hyyj04/Bio-Grip/Mentoring/팀활동 사진/260414_BioGrip팀사진2.jpg

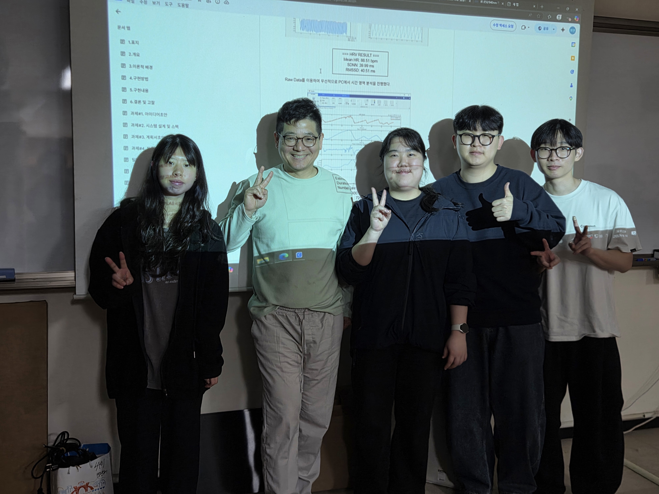
Mentoring/팀활동 사진/260414_BioGrip팀사진2.jpg
