hyyj04/Bio-Grip/Mentoring/멘토링.md

# 멘토링

4월 14일 회요일 
17:40 ~ 20:40

1. 동작에 필요한 AFE 모드 및 아두이노 보드 확보 및 단품동작확인
2. 마우스 분해하여 기구 관련 검토 진행중
    - 마우스 회로만 활용하구 기구는 3D 프린터로 출력필요
    - 공개된 디자인을 직접 출력하여 검토 후 모델선정
3.2개 트랙으로 진행
  - 아두이노에 AFE 연결하여 기본데이터 취득 및 PC로전송
  - PC에서는 받은데이터를 차트로 출력하고 필요한 필터를 설계하여 동작검토
4. 생체신호 측정은 AFE로 젲가 및 데이타 확보가 가능하지만 분석하여 원하는 피처를 찾는 과정이 시간이 많이 걸리고 난이도가 높ㅇ.ㅁ

기타
중간고사 끝나고 4월말 석식미팅

2026-05-28 17:30
415-1호 강의실
인원 : 조희재강사(삼성전자) / 임세훈(멘토) / 멘티
1. 진행
   - VScode 워크스페이스 설정 및 코파일럿 설정 / 코덱스 설정 .
   - 채팅창을 이용한 코드 실습 : ESP32 + 네오LED
   - 사양서를 이용한 코드 실습 : ESP32 + 네오 LED + Wifi
   -  AI에이전트 활용시 효율 올리는 방법 및 사양서의 중용성 / 기본템플릿 소개등
2. 근처 식당에서 늦은 식사를 같이 하면서 강사님 및 멘토와 회사 실무 및 AI 활용등 간담하면서 진행됨
3. 
AI활용한 프로젝트 구성 및 코드 개발 등의 실습 세미나로 2개 과제 같이 진행함.

2026-07-08 19:00  
1. 진행 상황 공유
 - 바이오 그립 과제는 6월에는 깃허브로 자료 공유및 이슈체크만 진행되고 오프라인 멘토링은 스킵
 - 하드웨어 제작 완료 및 PC연동으로 데이터 취득 및 평가/ 알고리즘으로 수치화까지 완료하여 졸작발표 완료
 - 졸작 진행 동영상 공유 및  동작 설명 진행

2. 중간 보고서 관련 이슈
 - 중간보고서는 일정준수가 필요하며 당일 서버 혼잡으로 다운등이 있으니 빠른 진행 당부
- 초안 작성되는데로 전달하면 리뷰하기로함

3. 과제 진행관련 이슈
 - 하드웨어 최적화를 적용하여 신규제작이슈
 - 마우스 구매 및 형상, 센서 배치등 의견 공유 및 토론

4. 프로젝트 중간까지 진행 응원하면서 식사로 멘토링 마무리
