hyyj04/Bio-Grip/Docs/docs/02_HW사양서.md

# BioGrip 하드웨어 사양서

## 1. 개요 (Introduction)

### 1.1. 문서 목적 및 범위 (Purpose & Scope)

본 사양서는 사용자의 인지적·물리적 부담을 최소화하는 마우스 일체형 무구속 생체신호 계측 시스템의 하드웨어 스펙을 정의한다. 기존 유선 마우스 하우징 내부의 한정된 공간에 메인 컨트롤러(Arduino Nano 33 BLE), 광학식 반사형 PPG 센서, 그리고 아날로그 GSR 전극 인터페이스 회로를 집적하기 위한 전기적, 기구적, 전원 관리 사양을 규정하여 시스템의 하드웨어 신뢰성을 보장하는 데 목적이 있다.

### 1.2. 시스템 하드웨어 블록도 (System Hardware Block Diagram)

본 시스템은 USB 5V 버스 전원을 Arduino Nano 33 BLE 보드의Vin을 통해 3.3V로 강하하여 전원을 공급받으며, I2C 및 아날로그 ADC 채널을 통해 복합 생체신호를 동시 취득한 후 내장 안테나를 통해 BLE 5.0 가상 시리얼 패킷으로 상향 전송한다.

```
+-------------------------------------------------------------------------------+
| [BioGrip 스마트 마우스 하우징 내부]                                            |
|                                                                               |
|  +--------------------+  USB 5V  +---------------------+                      |
|  | 기성 유선 마우스   |--------->| Arduino Nano 33 BLE |                      |
|  | 메인 보드 & 클릭부 |          |                     |                      |
|  +--------------------+          |  - MCU: nRF52840    |    BLE 5.0 무선      |
|                                  |  - 안테나 내장      |=====================>|
|  +--------------------+  I2C     |                     | (Feature 패킷 송신)  |
|  | MAX30105 PPG 모듈  |--------->|  - SDA (A4)         |                      |
|  | (엄지손가락 그립부)| (400kHz) |  - SCL (A5)         |                      |
|  +--------------------+          |                     |                      |
|                                  |                     |                      |
|  +--------------------+  Analog  |                     |                      |
|  | GSR 증폭 및 분압회로|--------->|  - A0 포트          |                     |
|  | (마우스 손바닥 접촉)| (ADC)   +---------------------+                      |
|  | (마우스 상부 하단부)|                    |
|  +--------------------+                     | 3.3V 정전압 출력                |
|           ^                                 v                                 |
|           +---------------------------------+                                 |
+-------------------------------------------------------------------------------+

```

---

## 2. 메인 컨트롤러 사양 (Main Controller Specification)

### 2.1. 메인 MCU: Arduino Nano 33 BLE 사양 

| 항목 (Parameter) | 상세 사양 (Specifications) | 엔지니어링 의미 및 비고 |
| --- | --- | --- |
| **핵심 프로세서** | Nordic Semiconductor nRF52840 | ARM Cortex-M4 32-bit RISC Core |
| **동작 클럭 주파수** | 64 MHz | 고속 생체 신호 필터링 알고리즘 실시간 연산 가능 |
| **FPU 내장 여부** | 하드웨어 FPU(부동소수점연산장치) 포함 | 알고리즘 연산 시 소수점 연산 속도 극대화 |
| **메모리 자원** | Flash Memory 1 MB / SRAM 256 KB | 실시간 Welford 알고리즘 및 링 버퍼 구동 공간 확보 |
| **임베디드 구동 환경**| Mbed OS 가상화 커널 기반 아두이노 Core | 멀티태스킹 및 시스템 스케줄링의 높은 안정성 |
| **동작 전압** | 내부 커널 및 I/O 로직 3.3V 구동 | 전력 효율성 및 센서 로직 레벨 매칭 최적화 |

* **구매처:** https://www.devicemart.co.kr/goods/view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

### 2.2. 무선 통신 인터페이스 (Wireless Communication) 

* **통신 규격:** Bluetooth Low Energy (BLE) 5.0 준수.
* **안테나 특성:** 내부 실장형 칩 안테나 (Embedded PCB 라이트하우스 구조).
* **RF 송신 출력:** 최대 +4 dBm (마우스와 호스트 PC 간의 2m 이내 근거리 통신 환경에서 패킷 드롭 최소화).

### 2.3. 하드웨어 핀 맵 및 가용 리소스 (Pin Mapping) 

* **I2C 통신 인터페이스** 
* * `SDA` 포트(A4): 하드웨어 고정 핀 매핑 (`Wire` 버스 연동)
* * `SCL` 포트(A5): 하드웨어 고정 핀 매핑 (`Wire` 버스 연동)

* **아날로그 계측 인터페이스:**
* `A0` 포트: 내장 10-bit Successive Approximation Register (SAR) ADC 채널 연동 (GSR 피부전도도 전압 입력 대역).

---

## 3. 센서 및 계측 회로 설계 사양 (Sensor & Interface Circuitry)

### 3.1. PPG (Photoplethysmography) 센서 인터페이스 

마우스 파지 시, 좌측의 엄지손가락 그립부에 배치되어 심박이 뛸 때의 혈류량의 차이에 따른 심박 정보를 취득하는 광학식 센서 모듈이다. 상세한 사양은 다음과 같다. 

| 항목 (Parameter) | 상세 사양 (Specifications) | 엔지니어링 의미 및 비고 |
| --- | --- | --- |
| **핵심 칩셋** | Maxim Integrated MAX30102 | 고정밀 광학 생체 신호 수집 전문 모듈 |
| **측정 원리** | 광혈류측정조절도 (PPG) | Red(적색, 660nm) 및 IR(적외선, 880nm) 이중 광원 활용 |
| **통신 인터페이스** | $I^2C$ (Fast Mode 지원, 최대 400kHz) | SDA, SCL 2개 라인으로 MCU와 데이터 송수신 |
| **동작 전압 (VCC)** | 3.3V ~ 5V | 모듈 내부에 1.8V 레듈레이터 포함 (칩셋 자체는 1.8V 구동) |
| **ADC 해상도** | 최대 18-bit (가변 설정 가능) | 미세 혈류 변화 변위 감지를 위한 높은 양자화 해상도 |
| **샘플링 레이트** | 50Hz ~ 3200Hz | 시스템 부하 및 나이퀴스트 이론 고려 가변 지정 가능 |
| **인터럽트 핀** | `INT` (Active Low) | FIFO 버퍼에 데이터가 쌓였을 때 MCU에 즉시 알림 |
| **소비 전력** | 초절전 모드(Shutdown) 지원 | 가동 중단 시 전류 소모를 극도로 제한 ($0.7\,\mu\text{A}$ 수준) |

* **하드웨어 융합형 FIFO 버퍼 내장:** 칩 내부에 32개 샘플 분량의 FIFO(First-In, First-Out) 데이터 버퍼가 내장되어 있어, 메인 MCU가 매 순간 센서를 감시하지 않아도 되므로 Mbed OS 환경에서 멀티태스킹 효율을 극대화할 수 있다.
* **주변 광 노이즈 제거 (Ambient Light Cancellation):** 내부에 특수 필터 회로가 장착되어 있어, 일상적인 전등 조명이나 태양광 등 주변 노이즈를 하드웨어 단에서 1차적으로 억제한 깨끗한 PPG 파형을 출력한다.

* **I2C 버스 제어 사양:** 레지스터 고속 스캔을 위한 Fast Mode(400kHz 클럭 동기화) 인터페이스 가동. 

* **구매처:** https://www.devicemart.co.kr/goods/view?no=13137639

* **펌웨어 연동 레지스터 설정 사양 (`ppg_sensor.setup`):** 
| 제어 레지스터 항목 | 설정치 | 엔지니어링 의미 및 물리적 스펙 |
| --- | --- | --- |
| **LED Pulse Amplitude** | `0x5F` | LED 구동 전류 대략 19.2mA 설정 (적색 및 적외선 LED 동일 적용) |
| **Sample Average** | `4` | 4개의 샘플을 하드웨어적으로 평균 수집하여 고주파 플리커 노이즈 감쇄 |
| **Led Mode** | `2` | Multi-LED Mode 가동 (Red + IR 이중 광원 샘플링 동시 제어) |
| **Sample Rate** | `100` | 하드웨어 내부 샘플링 레이트 100Hz 지정 |
| **Pulse Width** | `411` | LED 발광 펄스 폭 411 $\mu\text{s}$ 지정 (ADC 해상도 18-bit 매핑 연동) |
| **ADC Range** | `16384` | ADC 풀 스케일 범위를 16,384 nA (최대 해상도 수준)로 한정 지어 미세 혈류 미분 이득 최적화 |

### 3.2. GSR (Galvanic Skin Response) 전극 및 증폭 회로 

마우스의 상부 하단의 손바닥 그립부 전극을 통해 땀 발생 정도를 확인하여 정서적 각성 및 스트레스 상태를 추적하는 피부전도도 센서 모듈이다. 

| 항목 (Parameter) | 상세 사양 (Specifications) | 엔지니어링 의미 및 비고 |
| --- | --- | --- |
| **핵심 칩셋/모듈** | Seeed Studio Grove - GSR Sensor (101020052) | 하드웨어 기반 입력 신호 증폭 및 필터링 내장 |
| **통신 인터페이스** | 아날로그 전압 출력 (Analog Voltage) | 메인 MCU의 내장 ADC 채널(A0)로 전압 데이터 직결 |
| **동작 전압 (VCC)** | 3.3V / 5.0V 겸용 | 아두이노 Nano 33 BLE의 3.3V 전원단과 동기화 구동 |
| **소비 전류** | 대략 1.5 mA ~ 2.0 mA | 저전력 임베디드 시스템 및 웨어러블 디바이스 적합 |
| **측정 핑거 전극** | 니켈 도금 전극  | 마우스 하우징 이식 및 커스텀 전극 배치 가공 대응 |
| **신호 증폭단** | 내부 가변 저항(Potentiometer) 내장 | 기본 입력 게인(Gain) 조절을 통한 민감도 보정 가능 |
| **연결 커넥터** | Grove 4핀 인터페이스 (2.0mm 피치) | 고정 구조물 내부 배선 시 노이즈 및 단선 방지 |

* **구매처:**https://www.devicemart.co.kr/goods/view?no=1289992

* **ADC 해상도 매핑:** 아날로그 입력 전압 대역($0 \sim 3.3\text{V}$)을 $0 \sim 1023$ 디지털 스케일로 매핑하여 런타임 추적. 

* **분압 회로 (Voltage Divider) 설계 스펙:**
* 피부 저항($R_s$)의 미세 변동을 전압 변환하기 위해 고정 기준 저항($R_f = 100\text{k}\Omega, \pm0.1\%$ 초정밀급) 기반의 분압 네트워크 회로를 채택한다.
* 기준 전압($V_{cc} = 3.3\text{V}$) 대비 ADC 측정 전압($V_{out}$) 간의 전도도(Conductance, $G_s = 1/R_s$) 변환 관계식은 다음과 같이 물리적으로 정의된다.

$$V_{out} = V_{cc} \cdot \frac{R_f}{R_s + R_f}$$

* **임피던스 매칭 및 절연 사양:** 회로 입력단에 전압 팔로워(Op-Amp Voltage Follower)단을 전치 배치하여, 입력 임피던스를 극대화($>10\text{M}\Omega$)함으로써 계측 회로가 피부 고유 저항을 왜곡(Loading Effect)하는 현상을 원천 방지한다.

---

## 4. 물리적 설계 및 기구부 사양 (Physical & Mechanical Specification)

### 4.1. 유선 마우스 하우징 가공 및 컴포넌트 통합 설계

* **내부 적층 공간 확보:** 기존 유선 마우스 내부의 광학 인코더 및 휠 기구부를 제외한 중앙 여유 공간을 아두이노(메인 계측 모듈) 장착 영역으로 확정한다.

### 4.2. 인체공학적 센서/전극 배치 (Ergonomic Sensor Placement)

* **PPG 센서 기구 배치:** 마우스 조작 시 엄지손가락이 상시 밀착되는 좌측면 그립 영역(Left Side Grip Area)에 가로 $12\text{mm} \times$ 세로 $7\text{mm}$의 사각형을 타공하고 마우스 바깥쪽으로 센서 모듈을 위치시킨 후 연결선은 마우스 내부 쪽을 빼서 Arduino Nano 33 BLE 보드와 연결한다. 이러한 배치를 통해 마우스를 쥘 때 의식적인 가압 없이도 맥파 계측이 수행되도록 배치한다.
* **GSR 전극 기구 배치:** 손바닥 전체가 자연스럽게 안착되는 마우스 엉덩이 영역(상부 하단)에 기저 전극(Reference)을 배치해서 실장하여 조작 중에도 접촉이 일정한 손바닥의 위치로 최적의 통전 경로(Current Path)를 형성한다.

---

## 5. 전원 관리 사양 (Power Management)

### 5.1. 입력 전원원 및 정격 전압 (Power Supply)

* **입력 전원 사양:** 기성 유선 마우스가 공급받는 호스트 PC USB 버스 라인으로부터 $V_{bus} = 5\text{V DC} \, (\pm5\%)$ 전원을 병렬 분기하여 전원 입력단으로 활용한다.
* **소비 전류 한계 규격:** 계측 회로 및 BLE 무선 송신 버스트 가동 시의 순간 피크 전류를 포함하여 전체 추가 소비 전류가 $50\text{mA}$를 초과하지 않도록 제한하여 USB 포트 전원 차단(Over-current Protection)을 방지한다.

### 5.2. 전원 변환 (Voltage Regulation) 

* **레듈레이팅 아키텍처:** Arduino Nano 33 BLE 내부의 고효율 리니어 정전압 LDO를 거쳐 출력되는 고청결 $3.3\text{V}$ 전원을 오직 GSR 분압단과 MAX30105 센서의 아날로그 전원($V_{DD}$) 라인에만 단독 공급한다. 

---

## 6. 환경 및 신뢰성 사양 (Environmental & Reliability Requirements)

### 6.1. 전기적 안전성 (Electrical Safety)

* **미세 전류 제한 규격:** 사용자 피부에 상시 직접 접촉되는 GSR 금속 전극 표면으로 흐르는 인가 전류는 인체 안전 표준(IEC 60601-1 의료기기 안전 규격 준용)에 의거하여 정상 동작 및 단일 결함(Single Fault) 상황 조건에서도 최대 $10\mu\text{A}$ 이하로 유지되도록 회로적인 하드웨어 한계 저항($150\text{k}\Omega$ 이상의 직렬 보호 저항)을 강제 배치한다.

### 6.2. 하드웨어 노이즈 대책 (EMC/EMI)

* **기계적 노이즈 차단 사양:** 마우스의 좌/우 클릭 스위치(마이크로 타키온 스위치) 접점 개폐 시 발생하는 전기적 아크 노이즈와 마우스 광센서 스크롤 인코더의 역기전력 노이즈가 고감도 GSR/PPG 아날로그 계측 라인에 유입되는 것을 방지하기 위해 신호선을 최단거리 래치 구조로 배선하고, 아날로그 접지(GND)와 디지털 접지를 단일 포인트(Single-point Grounding)에서만 병합하는 스타 그라운드 구조를 적용한다.
