hyyj04/Bio-Grip/Docs/docs/06_FW개발로드맵.md

# BioGrip FW 개발 로드맵

## 1. 초기 기획 및 요구사항 분석 단계 (Phase 1: Planning & Analysis)

### 1.1. 프로젝트 목적 및 목표 정의

* 마우스 일체형 무구속(Non-intrusive) 생체신호 계측의 당위성 및 최종 스트레스 정량화 목표 수립.
* 일상적 PC 사용 환경을 해치지 않는 스마트 마우스 융합형 바이오 피드백 시스템 선언.

### 1.2. 시스템 요구 사양서(SRS) 확정

* **기능적 사양:** 다중 센서 샘플링 인터벌(PPG: 20ms, GSR: 100ms) 및 비트 패킹을 통한 데이터 축소 조건 규정.
* **비기능적 사양:** `delay()` 배제를 통한 실시간 연산 결정성 확보 및 SRAM 고갈 방지를 위한 정적 메모리 범위 획정.

### 1.3. 기술 스택 및 개발 환경 셋업

* nRF52840 기반 `Arduino Nano 33 BLE` 메인 제어 보드 채택 및 Mbed OS 코어 컴파일러 환경 무결성 검증.

---

## 2. 하드웨어 연동 및 드라이버 개발 단계 (Phase 2: HAL & Driver Development)

### 2.1. I2C 버스 최적화 및 MAX30105 드라이버 이식

* Fast Mode(400kHz) I2C 버스 가동 사양 매칭 및 광학 센서 FIFO 버퍼 레지스터 제어 무결성 검증.
* 적색/적외선 이중 광원 구동 전류(`0x5F`) 및 펄스 폭(411 $\mu\text{s}$) 타이밍 하드웨어 스펙 정립.

### 2.2. 아날로그 아키텍처 및 GSR ADC 드라이버 구현

* MCU 내장 10비트 SAR ADC 매핑을 통한 피부전도도 입력 대역 수립.
* 초정밀 기저 저항($100\text{k}\Omega, \pm0.1\%$) 기반 전압 분압 인터페이스 회로 설계 및 임피던스 매칭 검증.

### 2.3. 센서 개별 탈착(Open Circuit) 예외 처리 로직 구현

* 마우스 운용 중 빈번한 손가락 이탈 현상에 대응하는 광량 하한 역치 감지 및 `ppg_consecutiveNoFinger` 카운터 드라이버 설계.
* GSR 오픈 회로 발생 시 연산을 즉각 우회시키는 `gsr_contactOk` 플래그 제어 로직 탑재.

---

## 3. 핵심 신호 처리 알고리즘 구현 단계 (Phase 3: Core Algorithm Implementation)

### 3.1. PPG 전처리 및 실시간 Peak / IBI 추출 알고리즘

* 지수이동평균(EMA) 필터를 결합한 Pseudo-HPF 구현으로 초저주파 호흡 동잡음 베이스라인 변동 제거.
* 절대값 EMA 기반 동적 임계치(`ppg_PEAK_THRESHOLD_RATIO = 0.35`)와 불응기 시간 결합 피크 매칭 및 IBI 추출.
* 10개 프레임 이동 창 기반 변동계수(CV) 산출을 통한 SQI(신호 품질 평가) 게이팅 알고리즘 임베딩.

### 3.2. GSR Tonic(SCL) / Phasic(SCR) 분리 및 Peak 마이닝 알고리즘

* 150프레임 고정 크기 링 버퍼 기반 가속형 이동평균(MA) 필터를 가동하여 기저선 성분(SCL) 분리 연산 실현.
* Phasic 상승 위상 구간 EMA 업데이트 동결(Hold) 처리 및 최소 상승폭 역치 기반 SCR 피크 탐지 로직 구현.

### 3.3. 임베디드 자원 최적화형 Welford 통계 추적기 구현

* 배열 저장 방식 배제를 통해 SRAM 오버플로우를 차단하는 재귀형 단일 순회(Single-pass) 평균 및 분산 제곱합 누적 함수 검증.

---

## 4. 다중 센서 융합 및 데이터 축소 단계 (Phase 4: Sensor Fusion & Optimization)

### 4.1. 실시간 무차원 Z-Score 정규화 및 부호 반전 알고리즘

* `CALIBRATION` 구간(60초) 완료 시점 수렴된 고유 기저선 통계량을 기준으로 런타임 특징점 실시간 Z-Score 매핑.
* 스트레스 부하 시 하락하는 HRV 지표(`sdnn`, `rmssd`) 특성을 반영하기 위한 수학적 부호 반전(-) 수식 반영.

### 4.2. 다차원 통계 가용성 조건 기반 다중 센서 융합 알고리즘

* 각 센서 윈도우 신선도 및 접촉 상태 플래그를 교차 검증하여 최소 특징점 조건(`sys_validFeatureCount >= 3`) 만족 시에만 결합 평균 연산 승인.
* 통합 스트레스 지수 임계 조건 충족 여부에 따른 바이너리 런타임 상태 라벨(`Stress`/`Rest`) 판정 엔진 탑재.

### 4.3. 저전력 데이터 패킹 구조체 및 BLE GATT 프로토콜 스택 구현

* `#pragma pack(1)` 컴파일러 지시어 기반 밀집 바이트 구조체 설계를 통한 가상 패딩 바이트 발생 차단.
* 7대 특징 지표 유합 페이로드를 32바이트 구조체로 비트 패킹하여 원시 파형 전송 대비 **95% 이상의 무선 데이터 축소율(Data Reduction Rate)** 완성.

---

## 5. 시스템 디버깅, 성능 평가 및 보정 단계 (Phase 5: Debugging & Validation)

### 5.1. UART 시리얼 CSV 로깅 엔진 및 디버그 사양서(DBS) 검증

* `ENABLE_SERIAL_CSV = true` 가동을 통한 타임스탬프별 파이프라인 연산 데이터 쉼표(`,`) 격리 스트리밍 엔진 확인.
* 호스트 커맨드 입력 인터페이스('S': 전체 버퍼 올 클리어 및 측정 세션 개시, 'X': 연산 루프 서스펜드) 무결성 테스트.

### 5.2. 호스트 연동 분석(Python)을 통한 스트레스 분류 정확도 평가

* 런타임 시리얼 방출 CSV 로그 세션을 파이썬 분석 스크립트(`GSR_Stress_State.py`)로 유입하여 Ground Truth 구역 분석.
* 오차 행렬(Confusion Matrix) 추출 및 성능 평가 평가지표(Accuracy, Precision, Recall, F1-Score) 정량 도출.

### 5.3. 분류 편향(시소 현상) 극복을 위한 임계값 및 가중치 튜닝

* **현재 당면 과제 태스크:** 다중 실험 데이터에서 식별된 특정 클래스 과민 반응(STRESS 편향 및 REST 둔감 패턴) 집중 보정.
* 실제 마우스 조작 중 손의 가압 변화에 따른 동잡음 프로필을 역추적하여 SQI 게이팅 역치 및 융합 임계 조건 알고리즘 최적화 튜닝.

---

## 6. 학회 논문 투고 및 프로젝트 마무리 단계 (Phase 6: Submission & Deployment)

### 6.1. 대한전자공학회(IEIE) 학술대회 논문 Manuscript 작성

* '제안하는 임베디드 실시간 신호 처리 알고리즘' 수식 증명 및 '95% 데이터 축소율 성과 대비 스트레스 이진 분류 성능 결과' 섹션 체계적 정리.

### 6.2. 펌웨어 아키텍처 정의서(FAD) 및 최종 산출물 패키징

* SRAM 정적 할당 보고서, 기구부 타공 도면 및 EasyEDA 기반 PCB 거버(Gerber) 파일 최종 백업 패키징.

### 6.3. 캡스톤 디자인 최종 졸업 작품 발표 및 데모 테스트

* 심사위원단 대상 실시간 모니터링 대시보드 연동 마우스 하드웨어 최종 시연 및 졸업 작품 프로세스 최종 마감.
