hyyj04/Bio-Grip/Docs/docs/04_알고리즘설계서.md

# BioGrip 알고리즘 설계서

## 1. 개요 (Introduction)

### 1.1. 알고리즘 설계 목적 (Purpose)

본 설계서는 초소형 임베디드 자원 환경($\text{Arduino Nano 33 BLE}$)에서 구동되는 무구속 복합 생체신호 처리 파이프라인의 수학적·논리적 모델을 정의한다. 사용자의 손에 의해 유발되는 심각한 물리적 노이즈를 연산 부하 없이 실시간으로 정제하고, 피험자별 고유 베이스라인을 동적으로 추출하여 스트레스 상태를 정량화하는 것을 목적으로 한다.

### 1.2. 알고리즘 파이프라인 개요 (Pipeline Overview)

본 알고리즘은 단일 연산 루프 내부에서 고주파 PPG 파형과 저주파 GSR 신호를 독립 계측 및 전처리한 후, 통계적 다중 센서 융합 스택을 통해 상호 보완적인 최종 분류 지표를 매 초마다 도출한다. 

```
[Raw PPG] ➔ [EMA DC 필터] ➔ [적응형 피크 검출] ➔ [SQI 평가] ➔ [HRV 특징 추출] 
                                                                    | ➔ [Z-Score 변환] 
[Raw GSR] ➔ [미디언 필터] ➔ [SCL MA / SCR 분리] ➔ [Welford 분산 추적] ➔ [GSR 특징 추출] /       |
                                                                                          v
                                                                             [3개 이상 유효 조건 검증]
                                                                                          |
                                                                                          v
                                                                             [최종 통합 스트레스 판정]

```

---

## 2. 시간 기반 시퀀스 제어 및 예외 처리 알고리즘

### 2.1. 실험 매니지먼트 및 모드 제어 알고리즘

* 
**시간 경과 기반 자동 상태 전이 식 (`getMode`):** 시스템 측정 개시 후 경과 시간($t_{\text{elapsed}}$)에 따른 현재 연산 모드 $M(t)$는 다음과 같이 제어 조건문으로 정의된다. 

$$M(t) = \begin{cases} \text{STABILIZING}, & 0 \le t < T_{\text{stabilizing}} \\ \text{CALIBRATION}, & T_{\text{stabilizing}} \le t < T_{\text{baseline\_end}} \\ \text{REST}, & T_{\text{baseline\_end}} \le t < T_{\text{baseline\_end}} + T_{\text{rest}} \\ \text{TRANSITION}, & T_{\text{baseline\_end}} + T_{\text{rest}} \le t < T_{\text{baseline\_end}} + T_{\text{rest}} + T_{\text{trans}} \\ \text{STRESS}, & T_{\text{baseline\_end}} + T_{\text{rest}} + T_{\text{trans}} \le t < T_{\text{total\_end}} \\ \text{DONE}, & t \ge T_{\text{total\_end}} \end{cases}$$

*(소스 코드 기준: $T_{\text{stabilizing}} = 15\text{s}$, $T_{\text{baseline\_end}} = 75\text{s}$, $T_{\text{rest}} = 300\text{s}$, $T_{\text{trans}} = 30\text{s}$, $T_{\text{total\_end}} = 675\text{s}$ 적용)* 

* **`TRANSITION` 구간 연산 보류 논리:** 정상 상태에서 자극 상태로 전이 시 유발되는 일시적 거동 노이즈 오염을 방지하기 위해 $M(t) = \text{TRANSITION}$ 구간 내부에서는 특징 버퍼 업데이트 및 Z-Score 매핑을 강제 정지하고 결과값을 $\text{NAN}$으로 소거한다. 

### 2.2. PPG 기반 피부 미접촉(No-Finger) 감지 및 시스템 예외 처리

* **광량 기반 탈착 조건 판정 식:** 기득한 적외선 광학 밀도 값 $IR_{\text{raw}}$과 미접촉 판단 하한 역치($IR_{\text{thresh}} = 10,000$) 간의 관계식을 통해 미접촉 프레임 카운터 $C_{\text{nofinger}}$를 런타임 누적한다. 

$$C_{\text{nofinger}, t} = \begin{cases} C_{\text{nofinger}, t-1} + 1, & \text{if } IR_{\text{raw}, t} < IR_{\text{thresh}} \\ 0, & \text{if } IR_{\text{raw}, t} \ge IR_{\text{thresh}} \end{cases}$$

* **시스템 소프트웨어 서스펜드 조건:** 

$$C_{\text{nofinger}, t} \ge 10 \implies \text{Trigger Exception} \rightarrow \text{Halt Processing Pipeline}$$

카운터 조건 충족 즉시 센서 신호 처리 및 GSR 윈도우 업데이트 루프를 조기에 탈출($\text{return}$)함으로써 탈착 시 인입되는 화이트 노이즈에 의한 특징점 뭉개짐 현상을 완벽히 차단한다. 

---

## 3. PPG (심박변이도, HRV) 신호 처리 알고리즘

### 3.1. 실시간 DC 성분 제거 및 Baseline 추적 알고리즘

* **지수이동평균(EMA) 기반 기저선 추출 공식:** 혈류량의 광학 파형에 포함된 초저주파 호흡 동잡음을 분리하기 위한 동적 기저선 $B_{\text{ppg}, t}$의 재귀 산식은 다음과 같다. 

$$B_{\text{ppg}, t} = \alpha_{\text{ppg}} \cdot IR_{\text{raw}, t} + (1 - \alpha_{\text{ppg}}) \cdot B_{\text{ppg}, t-1}$$

*(단, 가중치 필터 계수 $\alpha_{\text{ppg}} = 0.01$)* 

* **의사 고주파 통과 필터(Pseudo-HPF) 정제 산식:** 

$$IR_{\text{filtered}, t} = IR_{\text{raw}, t} - B_{\text{ppg}, t}$$

### 3.2. 적응형 Peak 검출 및 IBI(Inter-Beat Interval) 산출 알고리즘

* **진폭 절대값 EMA 기반 동적 피크 임계치 공식:** 신호의 전체 진폭 스케일 변동에 적응하기 위해 정제된 파형의 절대값 EMA 변수 $AE_{\text{ppg}, t}$를 실시간 연산한다. 

$$AE_{\text{ppg}, t} = (1 - \beta_{\text{ppg}}) \cdot AE_{\text{ppg}, t-1} + \beta_{\text{ppg}} \cdot |IR_{\text{filtered}, t}|$$

*(단, 절대값 추적 계수 $\beta_{\text{ppg}} = 0.01$)* 

* **다중 조건 결합 피크 매칭 논리 수식:** 런타임 타임스탬프 $t_{\text{now}}$에서 다음 4가지 수학적 조건을 동시 만족하는 조건문이 성립할 때에만 유효한 심박 수축기 피크($\text{Peak} = \text{True}$)로 판정한다. 

$$\text{Peak}_t = \begin{cases} \text{True}, & \text{if } \left( IR_{\text{filtered}, t-1} > IR_{\text{filtered}, t-2} \right) \;\land\; \left( IR_{\text{filtered}, t-1} > IR_{\text{filtered}, t} \right) \\ & \land\; \left( IR_{\text{filtered}, t-1} > AE_{\text{ppg}, t} \cdot K_{\text{peak}} \right) \;\land\; \left( t_{\text{now}} - t_{\text{last\_peak}} > T_{\text{refractory}} \right) \\ \text{False}, & \text{otherwise} \end{cases}$$

*(설정 계수 사양: 동적 배율 $K_{\text{peak}} = 0.35$, 시간 불응기 $T_{\text{refractory}} = 300\text{ms}$)* 

* **Raw IBI(Inter-Beat Interval) 산출 공식:** 

$$\Delta t_{\text{IBI}} = t_{\text{now}} - t_{\text{last\_peak}}$$

### 3.3. 신호 품질 평가(SQI) 및 유효 IBI 선별 알고리즘

* **이동 윈도우 변동계수($\text{CV}$) 산출 산식:** 최근 유입된 10개 프레임의 IBI 배열 및 피크 진폭($Amp$) 배열에 대하여 변동계수 수식을 적용한다. 

$$CV_{\text{IBI}} = \frac{\sigma(\mathbf{IBI}_{10})}{\mu(\mathbf{IBI}_{10})}, \quad CV_{\text{Amp}} = \frac{\sigma(\mathbf{Amp}_{10})}{\mu(\mathbf{Amp}_{10})}$$

* **SQI 선형 결합 스코어링 및 게이팅 조건식:** 배열 내 변동성을 기반으로 각각 100점 만점 형태의 품질 지표 점수를 역산 사용한다. 

$$Score_{\text{IBI}} = \text{clamp}\left(100 \cdot \left(1 - \frac{CV_{\text{IBI}}}{0.45}\right), 0, 100\right)$$

$$Score_{\text{Amp}} = \text{clamp}\left(100 \cdot \left(1 - \frac{CV_{\text{Amp}}}{1.20}\right), 0, 100\right)$$

$$\text{Valid\_Window\_Flag} = \begin{cases} 1, & \text{if } \left(0.6 \cdot Score_{\text{IBI}} + 0.4 \cdot Score_{\text{Amp}}\right) \ge 50.0 \\ 0, & \text{otherwise} \end{cases}$$

품질 가중 점수가 50점 이상으로 스크리닝되어 $\text{Valid\_Window\_Flag} = 1$ 상태를 충족한 IBI 고청결 데이터 데이터만 HRV 특징 연산 버퍼(`ppg_ibiBuf`)로의 입식을 허용한다. 

### 3.3. 실시간 시간 영역 HRV 특징점 산출 알고리즘

* **평균 심박수 (Mean HR) 연산 공식:** 최대 30개의 유효 IBI 원형 큐 내에서 평균 자극 간격을 도출한 후 분당 타격 횟수로 최종 변환한다. 

$$\mu_{\text{IBI}} = \frac{1}{N} \sum_{i=0}^{N-1} \text{temp\_ibi}[i] \implies \text{ppg\_meanHR} = \frac{60000.0}{\mu_{\text{IBI}}}$$

* **실시간 $\text{SDNN}$ (IBI 표준편차) 산식:** 

$$\text{ppg\_sdnn} = \sqrt{\frac{1}{N-1} \sum_{i=0}^{N-1} \left(\text{temp\_ibi}[i] - \mu_{\text{IBI}}\right)^2}$$

* **실시간 $\text{RMSSD}$ (인접 차이 제곱평균제곱근) 산식:** 인접한 심박 주기 변동의 고주파 성분을 정량화하기 위해 연속된 IBI 간의 차분 제곱합을 기반으로 처리한다. 

$$\text{ppg\_rmssd} = \sqrt{\frac{1}{N-1} \sum_{i=1}^{N-1} \left(\text{temp\_ibi}[i] - \text{temp\_ibi}[i-1]\right)^2}$$

---

## 4. GSR (피부전기 활동, EDA) 신호 처리 알고리즘

### 4.1. 접촉 안정성 검증 및 미디언 필터 알고리즘

* **3-Point 실시간 미디언 필터 수학적 구현:** 아날로그 전압 취득 데이터($analysisGsr$)의 동잡음 스파이크를 제거하기 위해 3개 버퍼 원소에 대해 중간값 매칭 조건문을 가동한다. 

$$medianGsr = \begin{cases} a, & \text{if } (b \le a \le c) \lor (c \le a \le b) \\ b, & \text{if } (a \le b \le c) \lor (c \le b \le a) \\ c, & \text{otherwise} \end{cases}$$

*(단, $a = gsr\_medBuf[0], b = gsr\_medBuf[1], c = gsr\_medBuf[2]$)* 

### 4.2. Tonic(SCL) 성분 추출을 위한 이동평균 필터 알고리즘

* **15초 이동 윈도우 주기의 고속 MA 필터링 수식:** 전도도 신호의 서서히 변하는 기저 레벨(SCL)을 추출하기 위해 고정 크기 배열($N_{\text{ma}} = 150$)의 이동합을 축적 연산한다. 

$$\text{sclBaseline}_t = \frac{1}{N_{\text{ma}}} \sum_{i=0}^{N_{\text{ma}}-1} \text{medianGsr}_{t-i}$$

본 아키텍처는 매 루프마다 전체를 순회하지 않고 이전 이동합 구조를 재사용하여 계산 복잡도를 $O(1)$로 제어한다. 

$$\text{Sum}_t = \text{Sum}_{t-1} - \text{medianGsr}_{\text{old}} + \text{medianGsr}_{\text{new}}$$

### 4.3. Phasic(SCR) 성분 추출 및 Peak 검출 알고리즘

* **적응형 SCR EMA 기저선 추적 및 Hold 제어 수식:** 교감신경 활동에 의한 급격한 위상 변동(Phasic) 성분을 발굴하기 위해 별도의 동적 EMA 파형 $G_{\text{baseline}, t}$를 추적하되, 임계 반응 이상의 인입 감지 시에는 업데이트를 프리징하는 논리를 수립한다. 

$$G_{\text{baseline}, t} = \begin{cases} G_{\text{baseline}, t-1}, & \text{if } \left( \text{medianGsr}_t - G_{\text{baseline}, t-1} > \text{gsr\_scrThreshold} \cdot 0.7 \right) \;\land\; \text{Baseline\_Ready} \\ \alpha_{\text{gsr}} \cdot \text{medianGsr}_t + (1 - \alpha_{\text{gsr}}) \cdot G_{\text{baseline}, t-1}, & \text{otherwise} \end{cases}$$

*(설정 사양: 추적 계수 $\alpha_{\text{gsr}} = 0.02$, Phasic 파형 유도 식: $\text{phasic}_t = \text{medianGsr}_t - G_{\text{baseline}, t}$)* 

* **SCR 위상 피크 매칭 미분 조건식:** 최종 양의 Phasic 성분 $\text{phasicPos}_t = \max(0, \text{phasic}_t)$의 최근 3개 샘플 기울기를 미분하여 피크를 탐색한다. 

$$\text{SCR\_Peak}_t = \begin{cases} \text{True}, & \text{if } \left( \text{phasicPos}_{t-1} > \text{phasicPos}_{t-2} \right) \;\land\; \left( \text{phasicPos}_{t-1} \ge \text{phasicPos}_t \right) \\ & \land\; \left( \text{phasicPos}_{t-1} \ge \text{gsr\_scrThreshold} \right) \\ & \land\; \left( \text{phasicPos}_{t-1} - \text{phasicPos}_{t-2} \ge \text{gsr\_MIN\_SCR\_RISE}_t \right) \\ & \land\; \left( Index_{\text{sample}} - Index_{\text{last\_scr}} \ge 10 \right) \\ \text{False}, & \text{otherwise} \end{cases}$$

*(피구조적 파라미터 사양: 최소 피크 상승폭 역치 $\text{gsr\_MIN\_SCR\_RISE}_t = 2.0$, 불응 프레임 간격 = 10)* 

---

## 5. 실시간 통계 추적 및 다중 센서 융합 분류 알고리즘

### 5.1. 임베디드 자원 최적화형 Welford 알고리즘

* **재귀형 단일 순회 통계 업데이트 공식:** `CALIBRATION` 모드($60\text{s}$, 총 600개 프레임) 진입 시, 배열 저장 없이 입력값 $x_n$에 대해 무한 루프 평균 $\mu_n$과 편차 제곱합 $M_{2, n}$을 동적 누적 빌드업한다. 

$$\mu_n = \mu_{n-1} + \frac{x_n - \mu_{n-1}}{n}$$

$$M_{2, n} = M_{2, n-1} + (x_n - \mu_{n-1})(x_n - \mu_n)$$

* **최종 기저선 샘플 표준편차 수득 산식:** 

$$\sigma_n = \sqrt{\frac{M_{2, n}}{n - 1}}$$

본 공식을 소스 코드 내에서 `gsr_baselineSclMean`, `gsr_baselinePhasicStd` 등의 변수로 수렴시켜 개인별 고유 바이어스를 확정한다. 

### 5.2. 실시간 Z-Score 기반 특징 정규화 알고리즘

* **무차원 특징점 변환 공식:** 실시간으로 계산되어 나오는 30초 이동 윈도우 특징 지표값들을 정규화 스케일로 투영한다. 

$$Z(x) = \frac{x - \mu_{\text{baseline}}}{\max(\sigma_{\text{baseline}}, \text{Min\_Std})}$$

* **심박변이도(HRV) 지표에 대한 수학적 부호 반전 연산 식:** 
스트레스 자극 하에서 GSR 임피던스 특징 지표는 정비례 상승 상태를 보이나, HRV 지표인 `sdnn` 및 `rmssd`는 부교감신경 억제 작용으로 인해 역비례 하락 곡선을 그린다. 따라서 융합을 위해 다음과 같이 음(-)의 부호를 매칭하여 방향성을 강제 일치시킨다. 

$$\text{ppg\_sdnnStressZ} = - \left( \frac{\text{ppg\_sdnn} - \text{ppg\_baselineMeanSDNN}}{\max(\text{ppg\_baselineStdSDNN}, 5.0)} \right)$$

$$\text{ppg\_rmssdStressZ} = - \left( \frac{\text{ppg\_rmssd} - \text{ppg\_baselineMeanRMSSD}}{\max(\text{ppg\_baselineStdRMSSD}, 5.0)} \right)$$

### 5.3. 다중 센서 융합(Sensor Fusion) 기반 최종 스트레스 판정 알고리즘

* **가용 특징 지표점의 동적 집계 연산식:** 런타임 상태 프레임에서 품질 필터 통과 유효 플래그(`sys_ppgReadyForBle`, `sys_gsrReadyForBle`) 획득 상태에 따라 유효 지표 개수 $N_{\text{valid}}$와 Z-Score 총합 $Z_{\text{sum}}$을 결합 누적한다. 

$$Z_{\text{sum}} = \sum_{i \in \text{ValidFeatures}} Z_i, \quad N_{\text{valid}} = \text{Count}(\text{ValidFeatures})$$

* **다차원 통계 가용성 검증 및 최종 이진 상태 분류 판정 공식:** 시스템 최종 결정을 위한 최소 특징 요구 사양 규격($N_{\text{thresh}} = 3$) 충족 여부를 상시 검증하여, 부분적 미접촉이나 스파이크 발생 시 부적격 오진 발생을 알고리즘 단에서 완전 봉쇄한다. 

$$\text{Final\_Stress\_State} = \begin{cases} \text{"" (Invalid)}, & \text{if } N_{\text{valid}} < 3 \\ \text{"Stress"}, & \text{if } N_{\text{valid}} \ge 3 \;\land\; \left( \frac{Z_{\text{sum}}}{N_{\text{valid}}} \ge 1.0 \right) \\ \text{"Rest"}, & \text{if } N_{\text{valid}} \ge 3 \;\land\; \left( \frac{Z_{\text{sum}}}{N_{\text{valid}}} < 1.0 \right) \end{cases}$$
