hyyj04/Bio-Grip/Docs/docs/01_요구사양서.md

# 요구 사양서

## 1. 개요 (Introduction)

### 1.1. 시스템 목적 (Purpose)

본 시스템은 사용자가 일상적인 PC 환경에서 추가적인 장착 불편함 없이 스트레스 상태를 모니터링할 수 있도록, 마우스 조작 기반의 무구속(Non-intrusive) 생체신호 계측 환경을 제공하는 것을 목적으로 한다. 마우스에 내장된 PPG(광전용적맥파) 및 GSR(피부전기활동) 센서를 통해 복합 생체신호를 실시간으로 수집하고 분류 알고리즘을 거쳐 사용자의 스트레스 상태를 정량적으로 판정한다.

### 1.2. 시스템 범위 (Scope)

* **하드웨어 펌웨어:** Arduino Nano 33 BLE 메인 임베디드 제어 루프 설계 및 센서 레지스터 제어.

* **신호 처리 알고리즘:** 실시간 이동 창(Sliding Window) 기반 필터링, Welford 알고리즘 기반 통계량 추적, 특징점(Feature) 추출 및 다중 센서 융합 분류.

* **통신 아키텍처:** BLE 5.0 GATT 기반 프로토콜 스택을 통한 호스트 디바이스로의 실시간 특징 데이터 패킹 및 무선 전송.

### 1.3. 정의 및 약어 (Definitions and Acronyms)

* **PPG (Photoplethysmography):** 광전용적맥파. 혈류량 변화를 광학적으로 측정하는 신호.

* **GSR (Galvanic Skin Response):** 피부전기활동. 발한 작용에 따른 피부 저항 및 전도도 변화를 측정하는 신호.

* **HRV (Heart Rate Variability):** 심박변이도. 자율신경계 상태를 반영하는 자극 간격의 미세한 변동성.

* **SDNN / RMSSD:** HRV의 시간 영역 대표 지표로, 각각 인접 IBI의 표준편차와 차이 제곱평균의 제곱근.

* **SCL (Skin Conductance Level):** GSR의 Tonic 성분으로 서서히 변하는 피부 전도도의 기저선 수준.

* **SCR (Skin Conductance Response):** GSR의 Phasic 성분으로 자극에 의해 급격히 발생하는 피부 전도도 반응 지표.

* **Z-Score:** 표준점수. 개별 측정값을 평균과 표준편차를 이용하여 정규화한 무차원 지표.

### 1.4. 참조 문서 (References)

* Arduino Nano 33 BLE & nRF52840 Hardware Manual.
* MAX30102/MAX30105 Sensor Datasheet.
* Grove - GSR Sensor v1.2

---

## 2. 시스템 전반 설명 (General Description)

### 2.1. 시스템 아키텍처 구성도 (System Perspective)

본 시스템은 기성 유선 마우스 내부에 메인 MCU 보드와 센서 모듈을 조밀하게 통합 이식한 형태를 취한다. 하드웨어에서 연산된 결과물은 BLE 무선 채널을 통해 PC측 소프트웨어 인터페이스(애플리케이션)로 상향 전송된다.

```
[물리 마우스 하우징 내부]                       [무선 통신]       [호스트 PC / 앱]
+---------------------------------------+
|  +---------+    +------------------+  |
|  |   PPG   |    |       GSR        |  |
|  | (I2C)   |    | (Analog ADC)     |  |
|  +----+----+    +--------+---------+  |
|       |                  |            |
|  +----+------------------+---------+  |
|  |      Arduino Nano 33 BLE        |  |
|  |  - 실시간 신호 전처리 및 필터링     |  |
|  |  - Welford 알고리즘 특징 정규화  |  |   BLE 5.0
|  |  - 다중 센서 융합 스트레스 분류  |  |------------> [실시간 모니터링 UI]
|  |  - 구조체 비트 패킹 바이트 직렬화 |  |  (Notify)    - 데이터 시각화
|  +----------------+----------------+  |              - 상태 판정 로그 보관
+-------------------|-------------------+
                    | (시리얼 디버깅 가동 시)
                    v
             [cite_start][USB UART 인터페이스] (CSV 로그 추출) [cite: 5, 146]

```

### 2.2. 시스템 주요 기능 (System Functions)

* **동시 샘플링:** 고주파의 PPG 신호(25Hz, 40ms 간격)와 저주파의 GSR 신호(10Hz, 100ms 간격)를 상호 간섭 없이 동시 취득한다.

* **실시간 특징 추출:** 30초 크기의 이동 창(`COMMON_FEATURE_WINDOW_MS`) 내에서 연산 부하가 큰 전체 순회 방식 대신 실시간 갱신형 알고리즘을 가동한다.

* **다중 센서 융합:** 단일 생체신호의 오류를 보완하기 위해 가용 지표들의 정규화된 Z-Score 값을 다차원 평가하여 최종 바이너리 스트레스 상태(`Rest`/`Stress`)를 도출한다.

* **저전력 데이터 전송:** 모든 원시 파형 데이터의 무선 전송을 배제하고, 압축된 구조체 단위의 데이터만 50초 주기(`BLE_NOTIFY_INTERVAL_MS`)로 가동하여 대역폭 점유 및 전력 소모를 최소화한다.

### 2.3. 사용자 특징 및 환경 (User Characteristics & Assumptions)

* **대상 사용자:** 사무직, 개발자, 게이머 등 PC 및 마우스를 장시간 쥐고 사용하는 피험자를 대상으로 한다.
* **동작 가정:** 마우스를 쥐는 손의 물리적인 밀착 압력 변화와 마우스 조작 이탈(손을 떼는 행위)이 수시로 발생할 수 있음을 소프트웨어 제어 조건의 핵심 가정으로 수립한다.

---

## 3. 외부 인터페이스 요구사항 (External Interface Requirements)

### 3.1. 하드웨어 인터페이스 (Hardware Interfaces)

* **메인 제어 보드 사양:** Arduino Nano 33 BLE 커널 아키텍처 사양을 충족하며, 시스템 전원은 마우스의 USB VBUS 전력(5V)을 분배받아 보드의 Vin 단자로 들어간다. 레듈레이팅된 3.3V 전압 인터페이스로 동작한다.

* **PPG 센서 연동 인터페이스:** MAX30105 기반 모듈을 마우스 좌측 엄지손가락 그립 가공 영역에 타공 밀착한다. 하드웨어 인터페이스는 I2C 통신 프로토콜을 사용하며, 클럭 속도는 고속 모드(`I2C_SPEED_FAST`, 400kHz)를 준수해야 한다.

* **GSR 전극 계측 인터페이스:** 손바닥이 밀착되는 마우스 중앙 하단부에 2개의 전극을 나란히 배치하며, MCU의 아날로그 핀 `A0` 포트를 통해 아날로그-디지털 변환(10비트 해상도 ADC, 범위: 0 ~ 1023) 인터페이스를 구성한다.

### 3.2. 소프트웨어 및 통신 인터페이스 (Software & Communication Interfaces)

* **BLE 통신 프로토콜 서비스 사양:**
* 서비스 UUID: `19B10000-E8F2-537E-4F6C-D104768A1214` 

* 특징값 전송용 독출/알림 특성(Read/Notify Characteristic) UUID: `19B10001-E8F2-537E-4F6C-D104768A1214` (크기: 32바이트 고정 구조체) 

* 명령어 수신용 기입 특성(Write Characteristic) UUID: `19B10002-E8F2-537E-4F6C-D104768A1214` 

* **시리얼 UART 인터페이스 사양:** 통신 속도는 115200 bps 포트를 기본으로 사용하며, 호스트 PC로부터 문자 `'S'` 또는 `'s'` 수신 시 시스템 측정 프로세스를 가동하고, `'X'` 또는 `'x'` 접수 시 가동을 정지하는 문자 제어 프로토콜 규격을 준수한다. 
시리얼 통신은 디버그 시에만 사용하며, 실제 사용 환경에서는 사용되지 않고 BLE 통신만을 이용한다. 

---

## 4. 기능적 요구사항 (Functional Requirements)

### 4.1. 시스템 모드 제어 (System State & Mode Management)

* **[REQ-4.1.1]** 시스템은 전원이 인가되거나 시작 명령이 떨어지면 시간 경과에 따라 5단계의 내부 런타임 모드를 엄격히 통제해야 한다.

* **[REQ-4.1.2]** 세부 타이밍 상태 전이 규칙은 다음과 같이 선형적으로 제어되도록 요구한다:

* `STABILIZING` (안정화 모드): 시스템 시작 직후 0 ~ 15초 미만 구간.

* `CALIBRATION` (기준 수집 모드): 15초 이상 ~ 75초 미만 구간 (누적 60초간 피험자 고유 통계 베이스라인 정립).

* `REST` (정상/휴식 측정 모드): 75초 이상 ~ 375초 미만 구간 (300초간 동작).

* `TRANSITION` (자극 전환 모드): 375초 이상 ~ 405초 미만 구간 (30초간 물리 변동 노이즈 배제를 위해 특징 추출 일시 보류).

* `STRESS` (스트레스 유도 측정 모드): 405초 이상 ~ 675초 미만 구간 (270초간 동작).

* `DONE` (실험 종료 모드): 675초 이상 시점.

### 4.2. PPG 신호 처리 및 HRV 특징 추출 (PPG Signal Processing)

* **[REQ-4.2.1] 미접촉 예외 처리:** 기득한 IR 광량이 최소 유효 임계값(`ppg_NO_FINGER_IR_THRESHOLD = 10000`) 미만으로 떨어지는 이벤트가 연속으로 10회 이상 발생할 경우, 손가락이 마우스에서 이탈한 상태로 자동 판정하고 시스템 모드를 즉시 `NO_FINGER`로 전환하여 원시 파형 및 알고리즘 처리를 일시 서스펜드해야 한다.

* **[REQ-4.2.2] DC 제거 필터:** 원시 광학 신호에서 호흡 및 체온 변화 등으로 인해 발생하는 초저주파 베이스라인 변동을 제거하기 위해 지수이동평균(EMA) 필터 기법을 적용한 Pseudo-HPF(고주파 통과 필터)를 구현해야 한다.

$$ppg_baselineEma_t = \alpha \cdot ppg_latestIrRaw_t + (1 - \alpha) \cdot ppg_baselineEma_{t-1}$$

$$ppg_latestFiltered_t = ppg_latestIrRaw_t - ppg_baselineEma_t$$

*(단, 필터 가중치 $\alpha=0.01$ 규격 준수)* 

* **[REQ-4.2.3] 피크 검출 및 불응기 사양:** 필터링된 파형이 동적 임계값(`ppg_absEma * 0.35`)을 초과하고, 인접 피크 간의 최소 거리가 300ms(`ppg_REFRACTORY_MS`) 이상인 조건 만족 시에만 심장 박동 피크로 유효하게 인정하여 심박 주기(IBI)를 계산한다.

* **[REQ-4.2.4] 신호 품질 평가(SQI):** 최근 취득된 10개의 피크 버퍼 내에서 IBI와 피크 진폭값의 변동계수(CV)를 연산하여 가중 선형 결합 점수가 50점 이상을 만족하는 청결 데이터 구간일 때만 HRV 특징 추출기에 입력으로 제공하도록 제한한다.

* **[REQ-4.2.5] 실시간 HRV 계산:** 유효한 데이터가 확보되면 30개 크기의 순환 이동 윈도우 버퍼 내에서 실시간으로 SDNN 및 RMSSD 수식을 처리하여 런타임 결과값(`ppg_sdnn`, `ppg_rmssd`)을 업데이트해야 한다.

### 4.3. GSR 신호 처리 및 특징 추출 (GSR Signal Processing)

* **[REQ-4.3.1] 하한선 및 미디언 필터링:** 계측된 GSR 아날로그 ADC 값이 탈착 하한선(`gsr_MIN_VALID_GSR_ADC = 10`) 미만인 경우 무효 처리하며, 유효 범위 내 데이터는 동잡음 차단을 위해 3포인트 윈도우 기반 실시간 미디언 필터링 처리를 수행한다.

* **[REQ-4.3.2] SCL 기저선 성분 추출:** 전도도 신호의 Tonic 성분인 피부 전도도 수준(SCL) 추적을 위해 150개 샘플(총 15초 크기)의 이동평균 필터(Moving Average Filter)를 비동기형 링버퍼 형태로 고속 가속 구현해야 한다.

* **[REQ-4.3.3] Phasic SCR 피크 마이닝 알고리즘:**
* 피부 전도도 반응(SCR) 검출을 위해 $\alpha=0.02$ 가중치의 EMA 필터를 기본 적용하되, 신호가 급격히 상승하는 위상 구간에서는 임시로 기저선 EMA 업데이트를 동결(Freeze)하는 지연 로직을 수립한다.

* Phasic 변동 성분의 로컬 극대값 중 미분 기울기가 최소 상승폭 임계값(`gsr_MIN_SCR_RISE_ADC = 2.0`) 이상이고 불응기 샘플 조건(10개 샘플 이내 재검출 방지)을 동시에 만족할 때만 유효 SCR 피크 개수(`gsr_windowScrCount`) 및 진폭합(`gsr_windowScrAmpSum`) 사양을 가산한다.

* **[REQ-4.3.4] 실시간 Welford 알고리즘 가동:** 단일 순회 통계 연산 프로토콜인 Welford 알고리즘을 소스 내에 임베딩하여, `CALIBRATION` 구간 동안 누적되는 대량의 샘플에 대해 임베디드 SRAM 오버플로우 없이 정확한 실시간 기저선 표준편차를 도출해야 한다.

$$\mu_n = \mu_{n-1} + \frac{x_n - \mu_{n-1}}{n}$$

$$M_{2,n} = M_{2,n-1} + (x_n - \mu_{n-1})(x_n - \mu_n)$$

$$\sigma_n = \sqrt{\frac{M_{2,n}}{n - 1}}$$

### 4.4. 실시간 스트레스 분류 알고리즘 (Stress Classification)

* **[REQ-4.4.1] 개별 지표 Z-Score 동적 정규화:** `CALIBRATION` 모드에서 연산이 완료된 고유 베이스라인 통계량을 기준으로 런타임 특징값들을 실시간 무차원 정규화 지표로 투영한다. 단, 스트레스 상태에서 수치가 감소하는 HRV 계열의 지표(`ppg_sdnn`, `ppg_rmssd`) 특성을 반영하기 위해 PPG 계열 Z-Score 결과에 한해서는 수학적 부호 반전(-) 처리를 수행하여 통합의 일관성을 확보해야 한다.

* **[REQ-4.4.2] 다중 센서 데이터 융합 임계 조건:**
* 정규화된 각 서브 지표(GSR SCL_Z, SCR_Amp_Z, SCR_Freq_Z, PPG SDNN_Z, RMSSD_Z)들 중 유효 상태 플래그가 수립된 실시간 특징점의 개수를 카운팅한다.

* 실시간으로 연산 가용성이 증명된 5가지 특징점의 총합 개수가 최소 요구 규격인 3개 이상(`sys_validFeatureCount >= 3`)을 충족하는 프레임에 한해서만 통합 스트레스 지수(`sys_integratedStressZ`) 연산의 유효성을 최종 승인해야 한다.

* 승인 조건을 충족하면 유효 Z-Score 값들의 산술 평균을 산출하고, 임계값 조건(`sys_integratedStressZ >= 1.0`) 도달 여부에 따라 이진 스트레스 상태 라벨을 `Stress` 또는 `Rest` 상태로 매초 동적 판정 출력한다.

### 4.5. 저전력 BLE 데이터 패킹 및 전송 (Data Reduction & Transmission)

* **[REQ-4.5.1] 바이트 정렬 구조체 선언:** 하드웨어 아키텍처 의존성에 의한 패딩 바이트 발생을 차단하기 위해 컴파일러 지시어 `#pragma pack(1)` 규격을 적용한 밀집 바이트 구조체를 설계해야 한다.

* **[REQ-4.5.2] 페이로드 비트 사양:** 무선 송신 페이로드는 아래의 32바이트 규격 명세 레이아웃을 엄격히 준수하여 정렬 가공 전송되어야 한다.

| 바이트 오프셋 | 필드명 | 데이터 타입 | 데이터 설명 |
| --- | --- | --- | --- |
| 0 ~ 1 | `seq` | `uint16_t` | 시퀀스 넘버 (송신 패킷 카운터) |
| 2 ~ 5 | `mean_hr` | `float` | 실시간 분당 심박수 원값 |
| 6 ~ 9 | `final_ppg_stress_z` | `float` | 최종 PPG 파트 스트레스 Z-Score |
| 10 ~ 13 | `final_gsr_stress_z` | `float` | 최종 GSR 파트 스트레스 Z-Score |
| 14 ~ 17 | `integrated_stress_z` | `float` | 다중 센서 융합 통합 스트레스 Z-Score |
| 18 | `integrated_level` | `uint8_t` | 통합 판정 코드 (0: 미정, 1: Rest, 2: Stress) |
| 19 | `mode_code` | `uint8_t` | 현재 시스템 런타임 실험 모드 코드 (0 ~ 5, 시간에 따른 STABILIZING~DONE 모드의 변화) |
| 20 | `flags` | `uint8_t` | 센서 가용성 비트 플래그 (Bit0:PPG, Bit1:GSR, Bit2:Valid, Bit3:Active) |
| 21 ~ 31 | `reserved` | `uint8_t[11]` | 차후 다차원 지표 확장을 위한 예비 공간 패딩 |

---

## 5. 비기능적 요구사항 (Non-functional Requirements)

### 5.1. 성능 요구사항 (Performance Requirements)

* **[PER-5.1.1] 실시간 연산 결정성:** 메인 연산 루프는 하드웨어 블로킹 함수(예: `delay()`)의 사용을 원천 배제해야 하며, 주기적 밀리초 플래그 비교 연산 방식을 채택하여 각 센서 샘플링 인터벌 오차가 최대 $\pm1\text{ms}$ 임베디드 허용 한계 범위 내에서 무결하게 유지되도록 실시간 결정성을 보장해야 한다.

* **[PER-5.1.2] 신호 처리 대기 시간 최소화:** 각 센서 계측 시점부터 Z-Score 변환 및 센서 융합 판단 프로세스까지 도달하는 데이터 전파 지연 시간(Latency)은 50ms 이내로 완료되어야 한다.

### 5.2. 안정성 및 예외 처리 (Safety & Reliability)

* **[SAF-5.2.1] 의사 스트레스 방지:** 마우스 드래그, 클릭 조작 중 피험자의 그립 마찰 이동으로 인한 고주파 동잡음(Motion Artifact) 스파이크가 인입되는 상황에 대응하여, 전처리 단계의 3포인트 미디언 필터와 SQI 버퍼 검증 필터가 연동 가동됨으로써 오경보율(False Positive)을 전체 가동 프레임의 5% 미만 상태로 제어해야 한다.

* **[SAF-5.2.2] 메모리 고갈 방지:** 긴 실험 시간(최대 수 시간 연속 가동) 동안 동적 메모리 할당(`malloc()`, `free()`)에 의한 SRAM 조각화 및 릭(Leak) 현상이 발생하지 않도록, 모든 버퍼 구조는 컴파일 타임에 정적 배열 구조로 선언하고 포인터 인덱싱을 통한 원형 큐(Circular Queue) 형태로 가용 메모리를 한정 관리해야 한다.
