hyyj04/Bio-Grip/Mentoring/팀활동 사진/260414_BioGrip 팀사진1.jpg

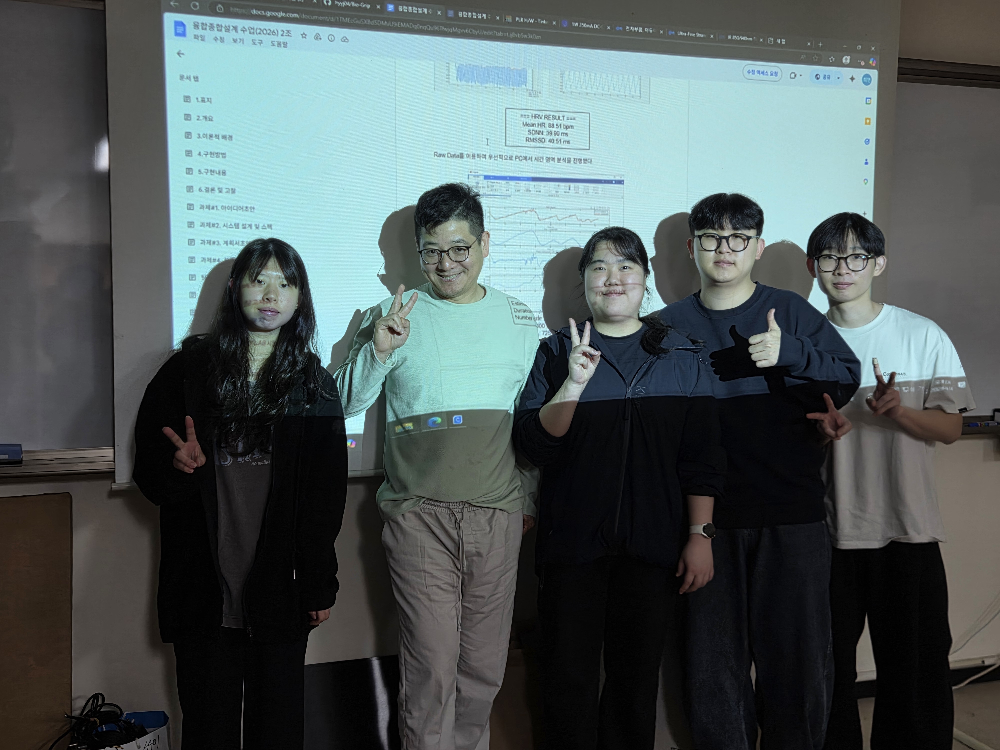
Mentoring/팀활동 사진/260414_BioGrip 팀사진1.jpg
