hyyj04/Bio-Grip/Mentoring/팀활동 사진/20260708_185919.jpg

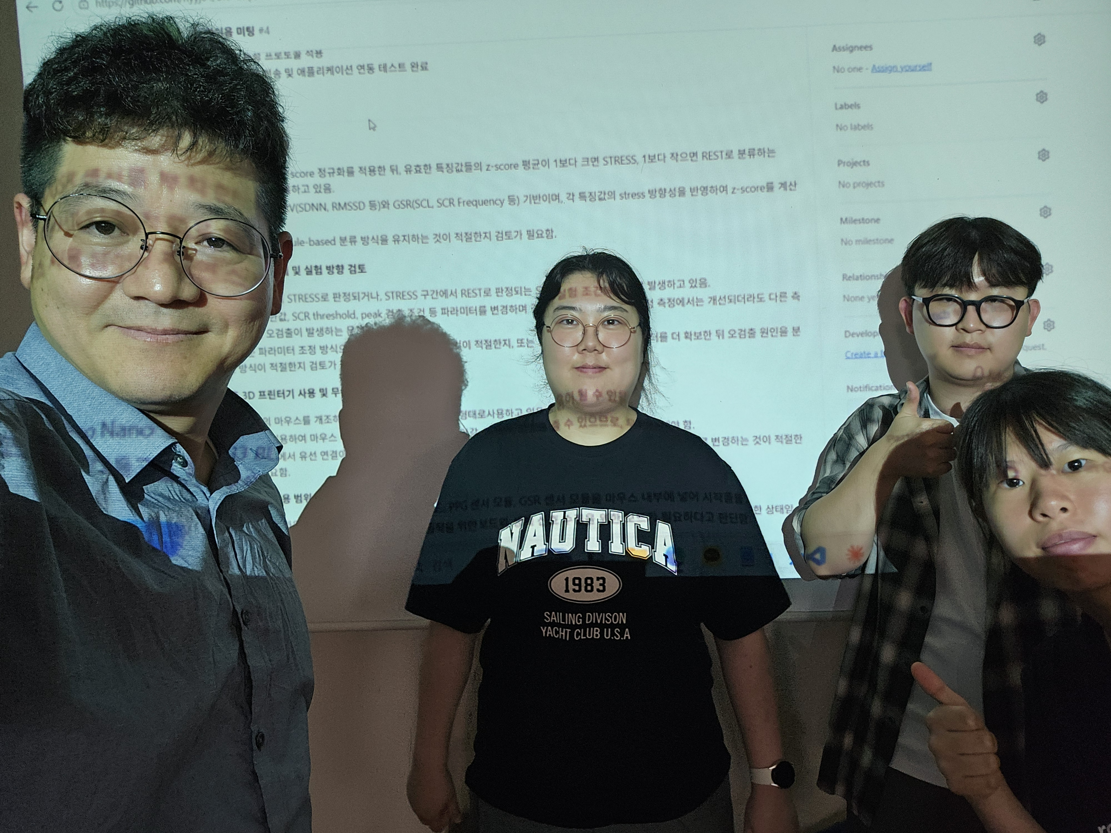
Mentoring/팀활동 사진/20260708_185919.jpg
