hyyj04/Bio-Grip/ppg_gsr_integrated_results/ppg_gsr_integrated_20260503_215329.csv

time_ms | ppg_mode | ir_raw | filtered_ppg | ibi_ms | valid_ibi_ms | mean_hr | sdnn | rmssd | baseline_mean_hr_mean | baseline_mean_hr_std | baseline_sdnn_mean | baseline_sdnn_std | baseline_rmssd_mean | baseline_rmssd_std | baseline_ibi_mean | baseline_ibi_std | sqi_score | valid_window_flag | mean_hr_z | sdnn_z | rmssd_z | mean_hr_stress_score | sdnn_stress_score | rmssd_stress_score | ppg_avg_score | hrv_score | final_ppg_stress_score | final_ppg_stress_level | ibi_count | baseline_count | no_finger_count | gsr_mode | gsr_sample_index | raw_gsr | median_gsr | scl_baseline | scr_detect_baseline | phasic | phasic_pos | scl_mean_30s | scr_amplitude_mean_30s | ns_scr_frequency_per_min | scl_mean_z | scr_amplitude_mean_z | ns_scr_frequency_z | scl_stress_score | scr_amplitude_stress_score | ns_scr_frequency_stress_score | final_gsr_stress_score | gsr_feature_ready | gsr_contact_ok | gsr_valid_sample_flag | integrated_stress_score | integrated_stress_level | pc_elapsed_sec | analysis_ppg_mode | analysis_gsr_mode | time_sec
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
