hyyj04/Bio-Grip/ppg_gsr_integrated_results/ppg_gsr_integrated_serial_v4scr수정후1차측정.csv

timestamp | mode | raw_gsr | ir_raw | filtered_ppg | ppg_mean_hr | ppg_sdnn | ppg_rmssd | gsr_scl | gsr_scr_amp | gsr_scr_freq | gsr_scr_count_30s | gsr_scr_single_peak_flag | gsr_scr_enough_for_score_flag | final_ppg_stress_z | final_gsr_stress_z | valid_feature_count | integrated_stress_z | integrated_state
0 | STABILIZING | 317 | 101031 | 0.00 |  |  |  |  |  |  | 0 | 0 | 0 |  |  | 0
1023 | STABILIZING | 380 | 102401 | 1127.13 |  |  |  |  |  |  | 0 | 0 | 0 |  |  | 0
2024 | STABILIZING | 400 | 102592 | 985.97 |  |  |  |  |  |  | 0 | 0 | 0 |  |  | 0
3028 | STABILIZING | 383 | 102591 | 765.10 |  |  |  |  |  |  | 0 | 0 | 0 |  |  | 0
4065 | STABILIZING | 384 | 101906 | 1.16 |  |  |  |  |  |  | 0 | 0 | 0 |  |  | 0
5066 | STABILIZING | 411 | 102271 | 279.66 |  |  |  |  |  |  | 0 | 0 | 0 |  |  | 0
6066 | STABILIZING | 416 | 102706 | 622.05 |  |  |  |  |  |  | 0 | 0 | 0 |  |  | 0
7067 | STABILIZING | 422 | 102043 | -94.29 |  |  |  |  |  |  | 0 | 0 | 0 |  |  | 0
8068 | STABILIZING | 422 | 102060 | -91.55 |  |  |  |  |  |  | 0 | 0 | 0 |  |  | 0
9068 | STABILIZING | 424 | 102217 | 70.02 |  |  |  |  |  |  | 0 | 0 | 0 |  |  | 0
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
