hyyj04/Bio-Grip/ppg_gsr_integrated_results/ppg_gsr_integrated_serial_v5수정후rest만측정.csv

timestamp | mode | raw_gsr | ir_raw | filtered_ppg | ppg_mean_hr | ppg_sdnn | ppg_rmssd | gsr_scl | gsr_scr_amp | gsr_scr_freq | gsr_scr_count_30s | gsr_scr_single_peak_flag | gsr_scr_enough_for_score_flag | gsr_scr_single_with_scl_rise_flag | final_ppg_stress_z | final_gsr_stress_z | valid_feature_count | integrated_stress_z | integrated_state
0 | STABILIZING | 333 | 101347 | 0.00 |  |  |  |  |  |  | 0 | 0 | 0 | 0 |  |  | 0
1026 | STABILIZING | 247 | 101994 | 562.87 |  |  |  |  |  |  | 0 | 0 | 0 | 0 |  |  | 0
2065 | STABILIZING | 255 | 101189 | -340.62 |  |  |  |  |  |  | 0 | 0 | 0 | 0 |  |  | 0
3066 | STABILIZING | 252 | 100241 | -1104.45 |  |  |  |  |  |  | 0 | 0 | 0 | 0 |  |  | 0
4105 | STABILIZING | 324 | 101791 | 525.65 |  |  |  |  |  |  | 0 | 0 | 0 | 0 |  |  | 0
5106 | STABILIZING | 322 | 101211 | -94.40 |  |  |  |  |  |  | 0 | 0 | 0 | 0 |  |  | 0
6107 | STABILIZING | 289 | 100933 | -319.45 |  |  |  |  |  |  | 0 | 0 | 0 | 0 |  |  | 0
7107 | STABILIZING | 346 | 101478 | 187.58 |  |  |  |  |  |  | 0 | 0 | 0 | 0 |  |  | 0
8108 | STABILIZING | 353 | 101516 | 176.18 |  |  |  |  |  |  | 0 | 0 | 0 | 0 |  |  | 0
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
