hyyj04/Bio-Grip/ppg_gsr_integrated_results/ppg_gsr_integrated_serial_v5파라미터수정후rest만측정.csv

timestamp | mode | raw_gsr | ir_raw | filtered_ppg | ppg_mean_hr | ppg_sdnn | ppg_rmssd | gsr_scl | gsr_scr_amp | gsr_scr_freq | gsr_scr_count_30s | gsr_scr_single_peak_flag | gsr_scr_enough_for_score_flag | gsr_scr_single_with_scl_rise_flag | final_ppg_stress_z | final_gsr_stress_z | valid_feature_count | integrated_stress_z | integrated_state
0 | STABILIZING | 654 | 98195 | 0.00 |  |  |  |  |  |  | 0 | 0 | 0 | 0 |  |  | 0
1018 | STABILIZING | 655 | 97499 | -659.71 |  |  |  |  |  |  | 0 | 0 | 0 | 0 |  |  | 0
2054 | STABILIZING | 655 | 94883 | -2905.09 |  |  |  |  |  |  | 0 | 0 | 0 | 0 |  |  | 0
3055 | STABILIZING | 654 | 95104 | -2009.28 |  |  |  |  |  |  | 0 | 0 | 0 | 0 |  |  | 0
4056 | STABILIZING | 654 | 94238 | -2221.48 |  |  |  |  |  |  | 0 | 0 | 0 | 0 |  |  | 0
5056 | STABILIZING | 653 | 96148 | -16.29 |  |  |  |  |  |  | 0 | 0 | 0 | 0 |  |  | 0
6058 | STABILIZING | 654 | 93757 | -2146.88 |  |  |  |  |  |  | 0 | 0 | 0 | 0 |  |  | 0
7058 | STABILIZING | 654 | 93955 | -1473.84 |  |  |  |  |  |  | 0 | 0 | 0 | 0 |  |  | 0
8060 | STABILIZING | 655 | 94608 | -461.88 |  |  |  |  |  |  | 0 | 0 | 0 | 0 |  |  | 0
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
