hyyj04/Bio-Grip/ppg_gsr_integrated_results/graphs_20260503_215329/03_mean_hr.png

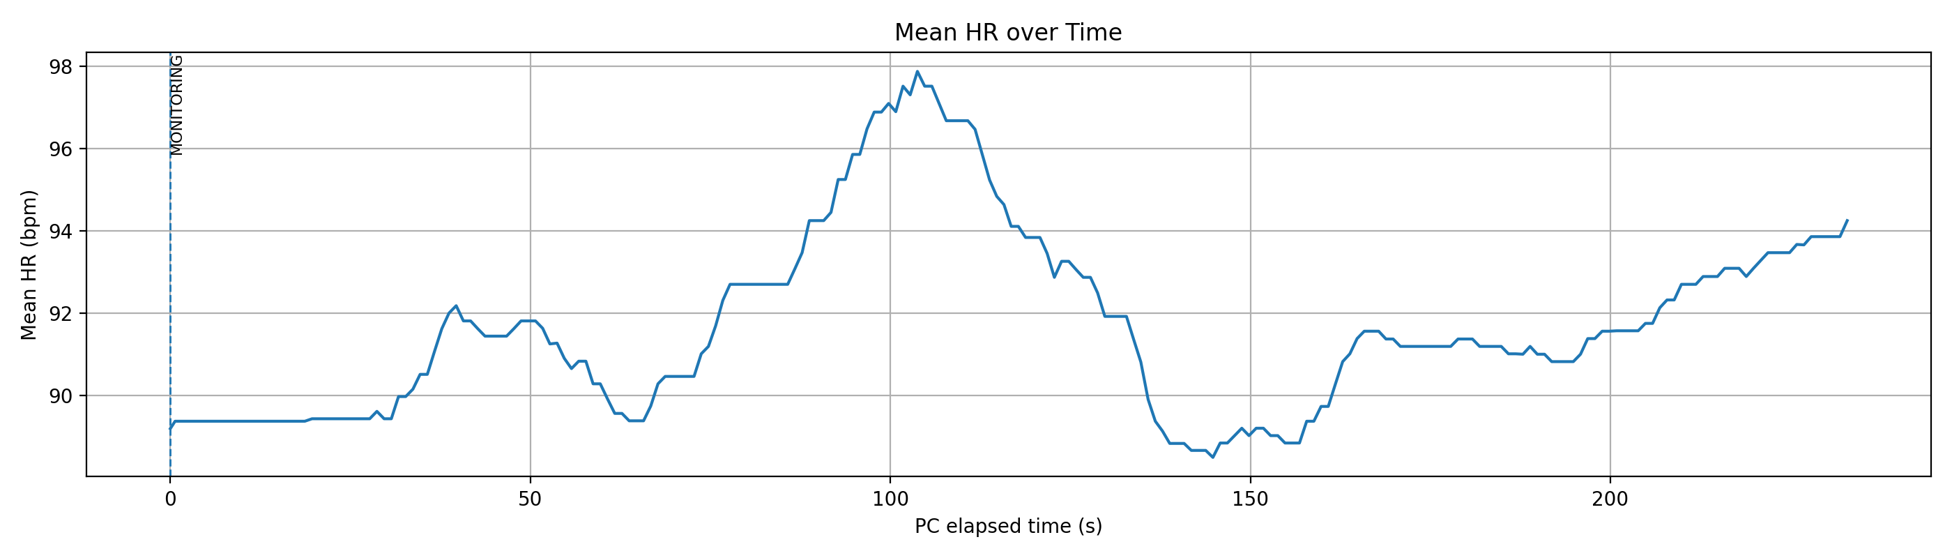
ppg_gsr_integrated_results/graphs_20260503_215329/03_mean_hr.png
