hyyj04/Bio-Grip/ppg_gsr_integrated_results/graphs_20260503_215329/05_rmssd.png

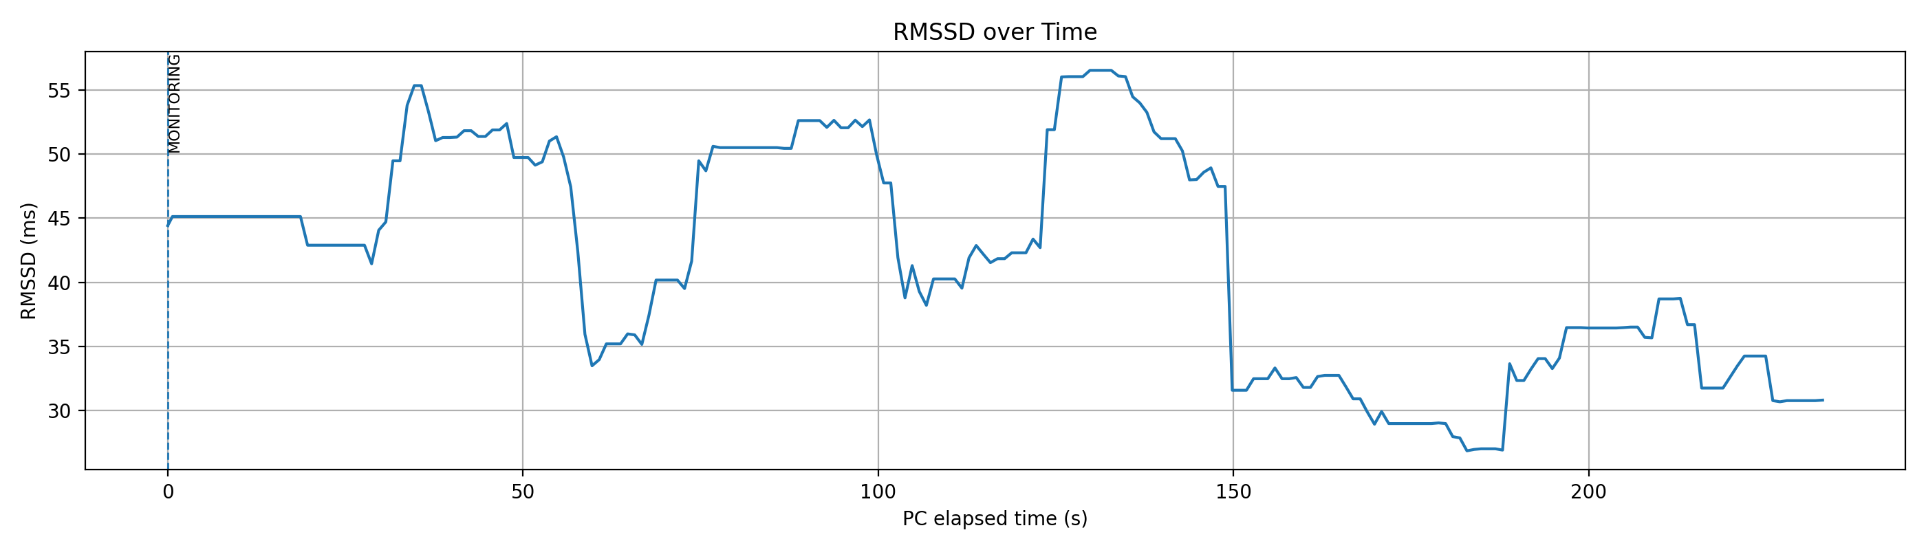
ppg_gsr_integrated_results/graphs_20260503_215329/05_rmssd.png
