hyyj04/Bio-Grip/ppg_gsr_integrated_results/graphs_20260503_215329/07_raw_gsr.png

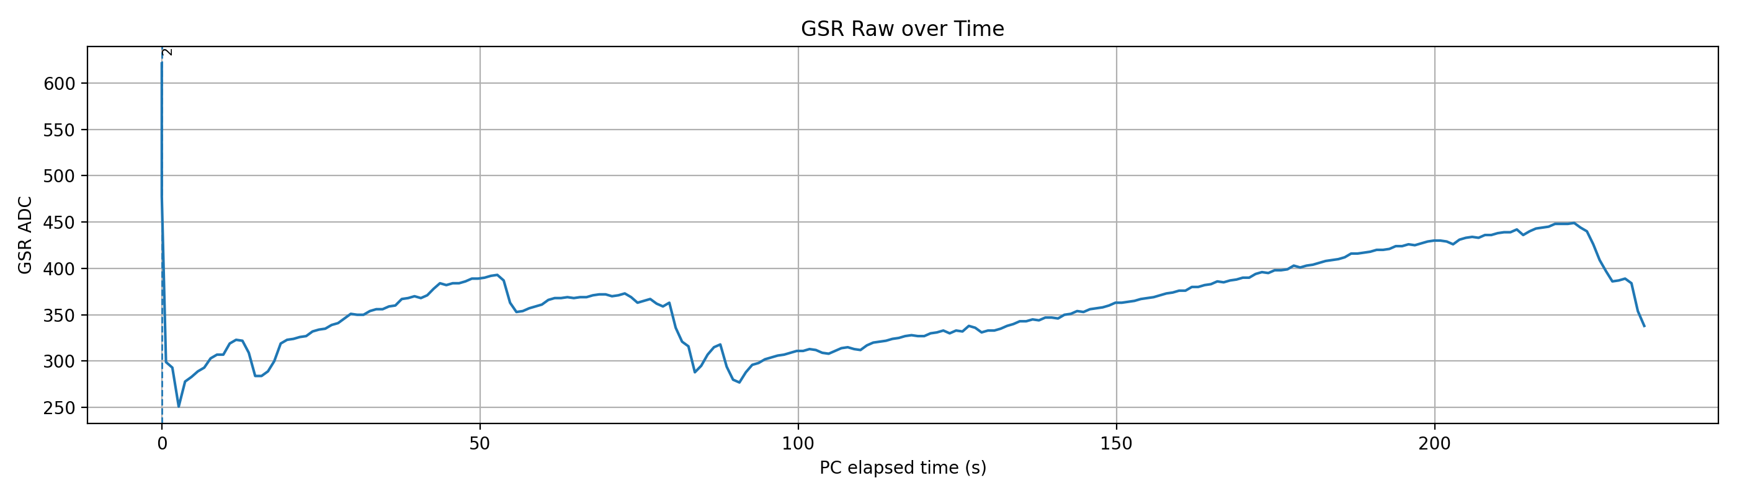
ppg_gsr_integrated_results/graphs_20260503_215329/07_raw_gsr.png
