hyyj04/Bio-Grip/ppg_gsr_integrated_results/graphs_20260503_215329/08_scl_mean_30s.png

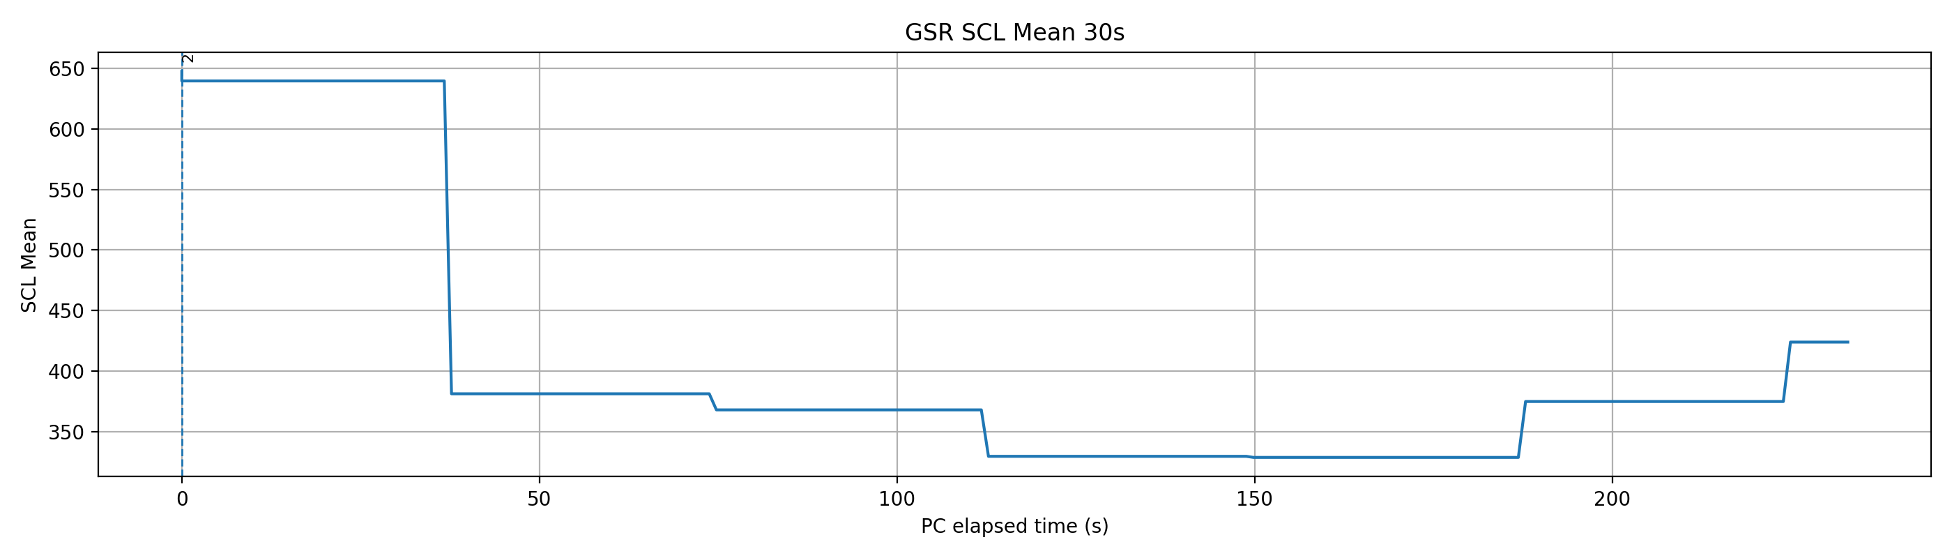
ppg_gsr_integrated_results/graphs_20260503_215329/08_scl_mean_30s.png
