hyyj04/Bio-Grip/ppg_gsr_integrated_results/graphs_20260503_215329/09_scr_amplitude_30s.png

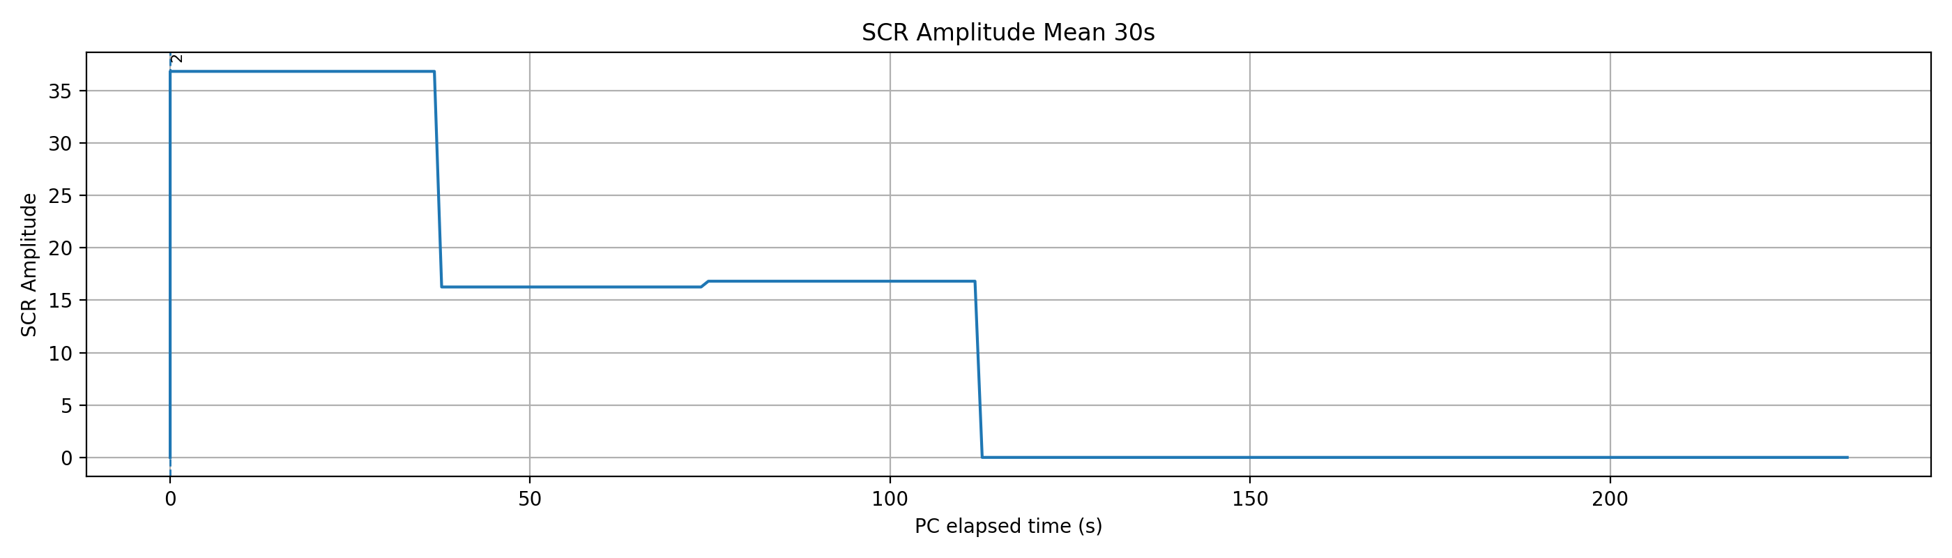
ppg_gsr_integrated_results/graphs_20260503_215329/09_scr_amplitude_30s.png
