hyyj04/Bio-Grip/ppg_gsr_integrated_results/graphs_20260503_215329/10_ns_scr_frequency.png

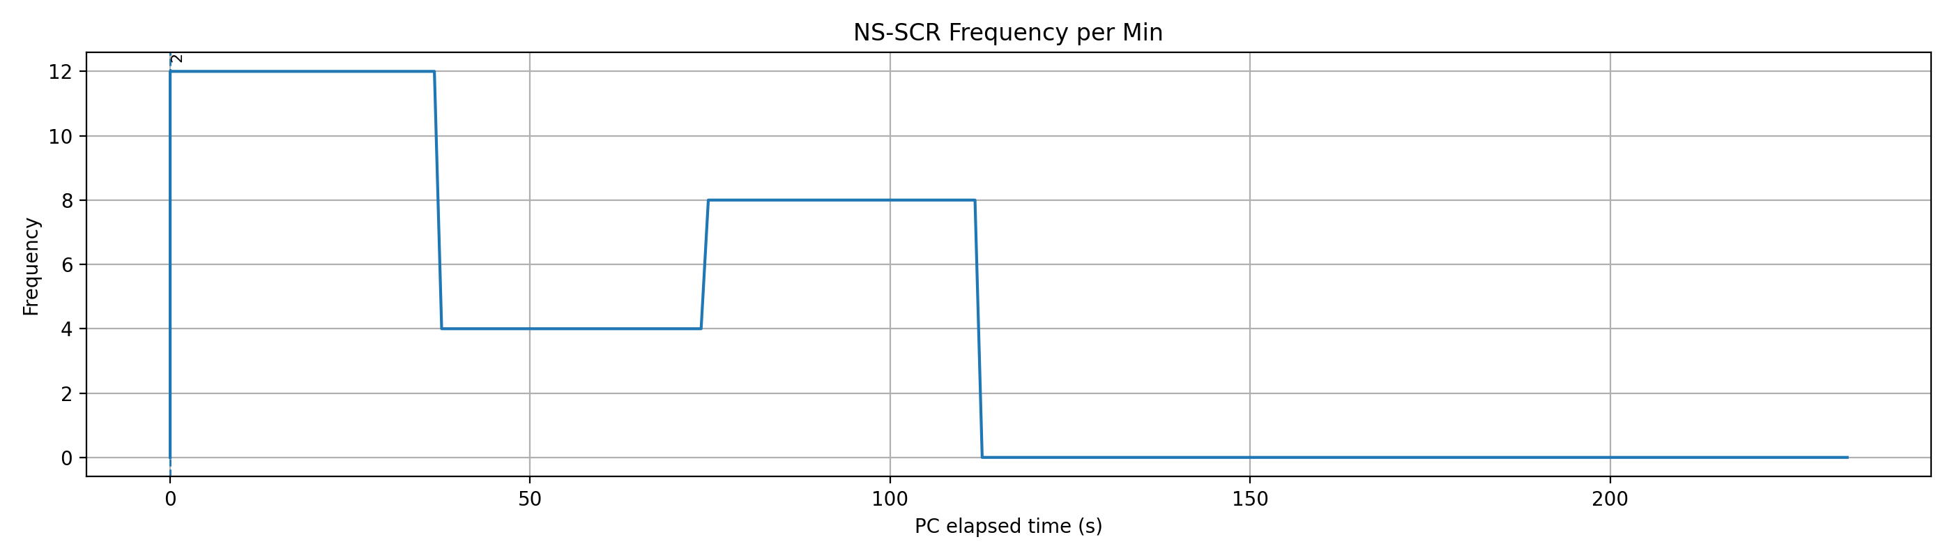
ppg_gsr_integrated_results/graphs_20260503_215329/10_ns_scr_frequency.png
