hyyj04/Bio-Grip/ppg_gsr_integrated_results/graphs_20260503_215329/11_final_ppg_score.png

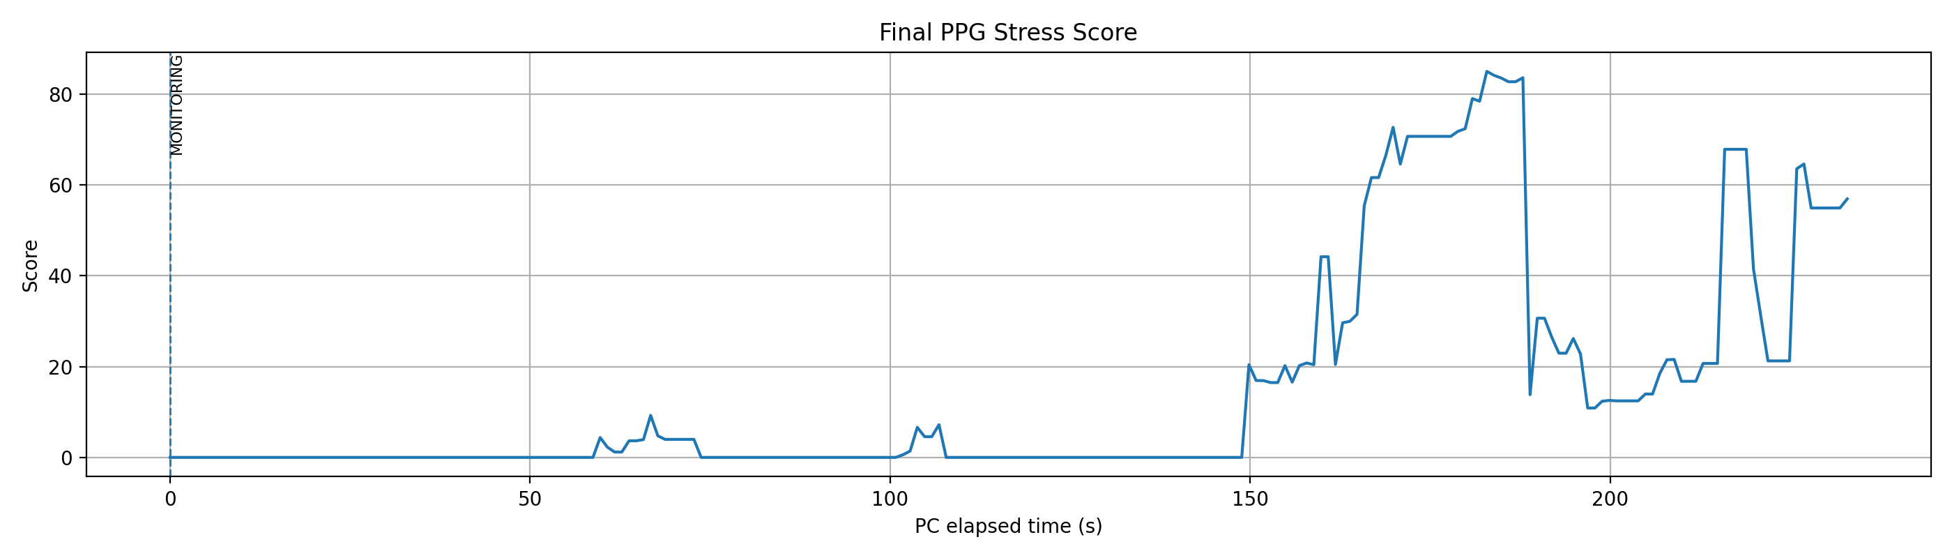
ppg_gsr_integrated_results/graphs_20260503_215329/11_final_ppg_score.png
