hyyj04/Bio-Grip/ppg_gsr_integrated_results/graphs_20260503_215329/13_integrated_score.png

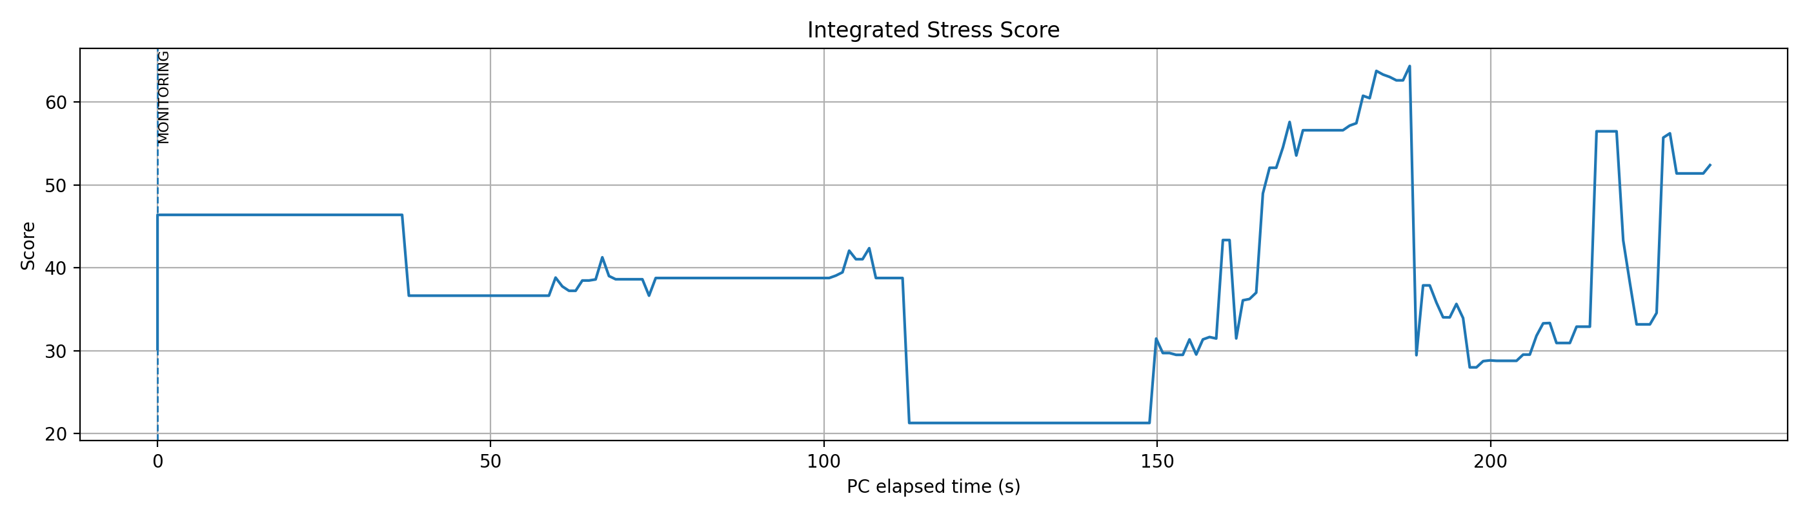
ppg_gsr_integrated_results/graphs_20260503_215329/13_integrated_score.png
