hyyj04/Bio-Grip/ppg_realtime_results/graphs_20260503_171810/01_ir_raw.png

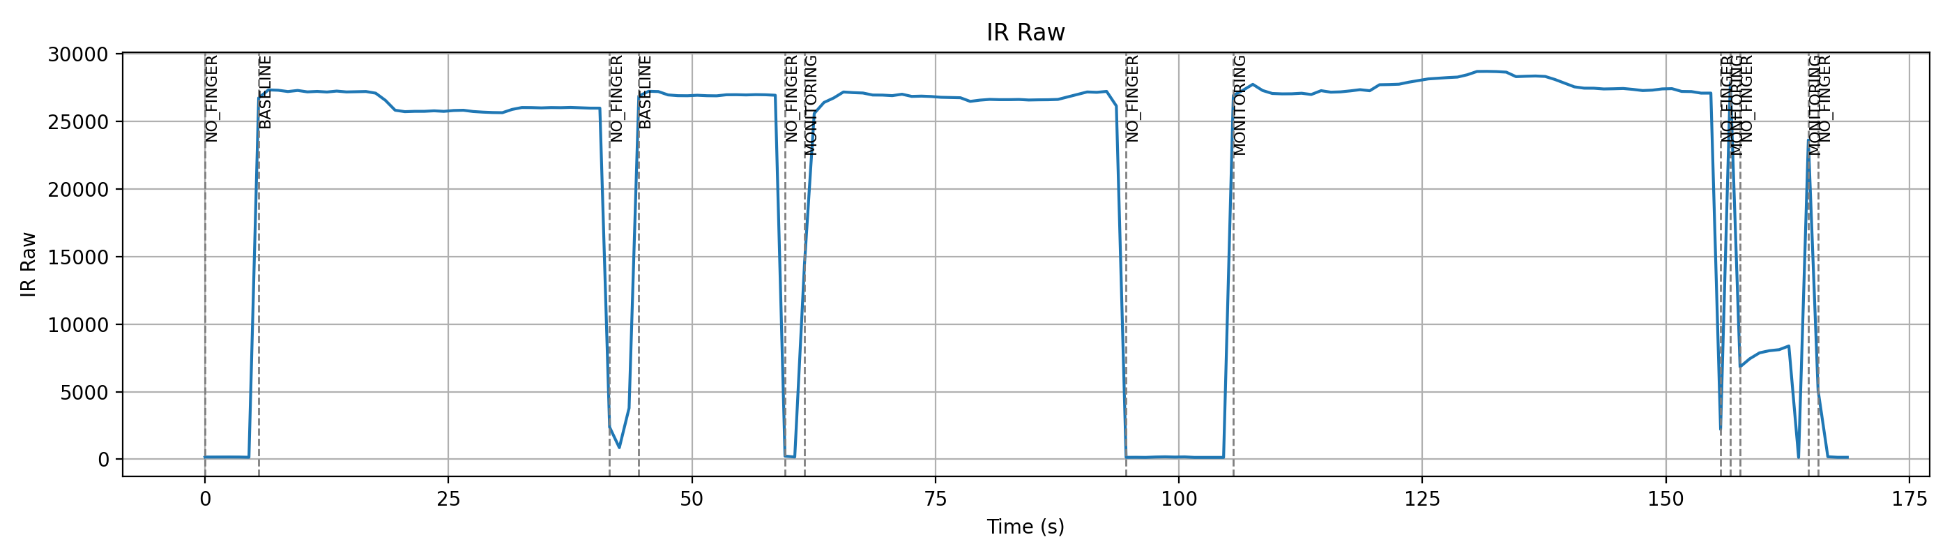
ppg_realtime_results/graphs_20260503_171810/01_ir_raw.png
