hyyj04/Bio-Grip/ppg_realtime_results/graphs_20260503_171810/02_filtered_ppg.png

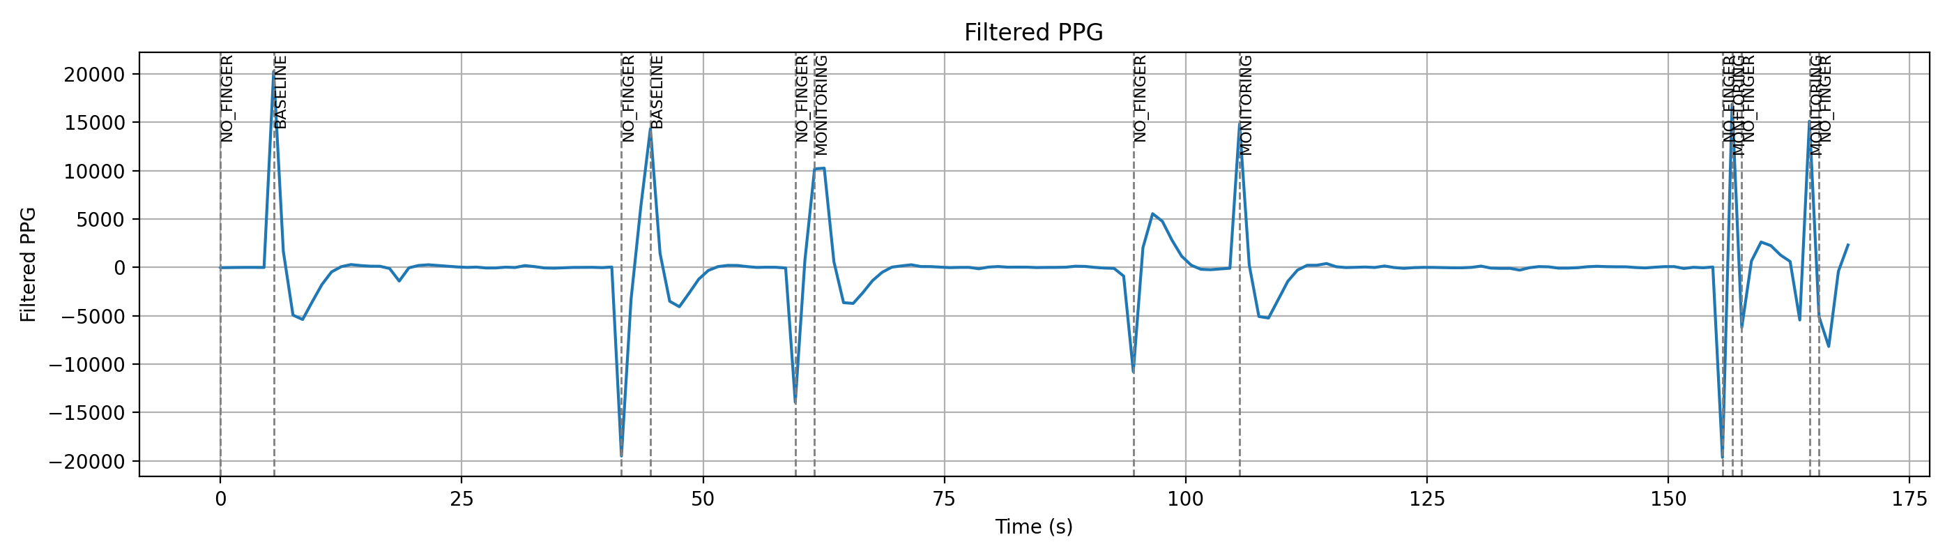
ppg_realtime_results/graphs_20260503_171810/02_filtered_ppg.png
