hyyj04/Bio-Grip/ppg_realtime_results/graphs_20260503_171810/05_rmssd.png

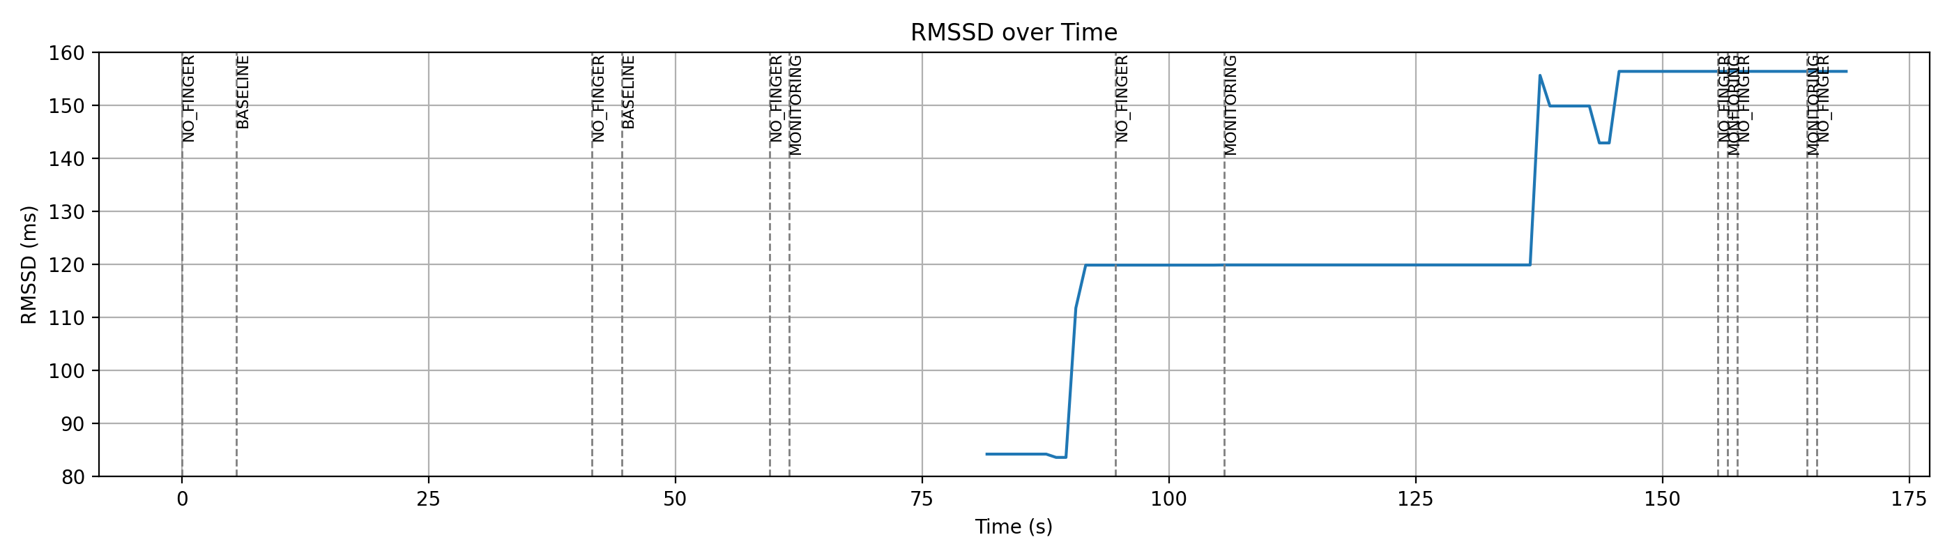
ppg_realtime_results/graphs_20260503_171810/05_rmssd.png
