hyyj04/Bio-Grip/ppg_realtime_results/graphs_20260503_171810/06_valid_ibi.png

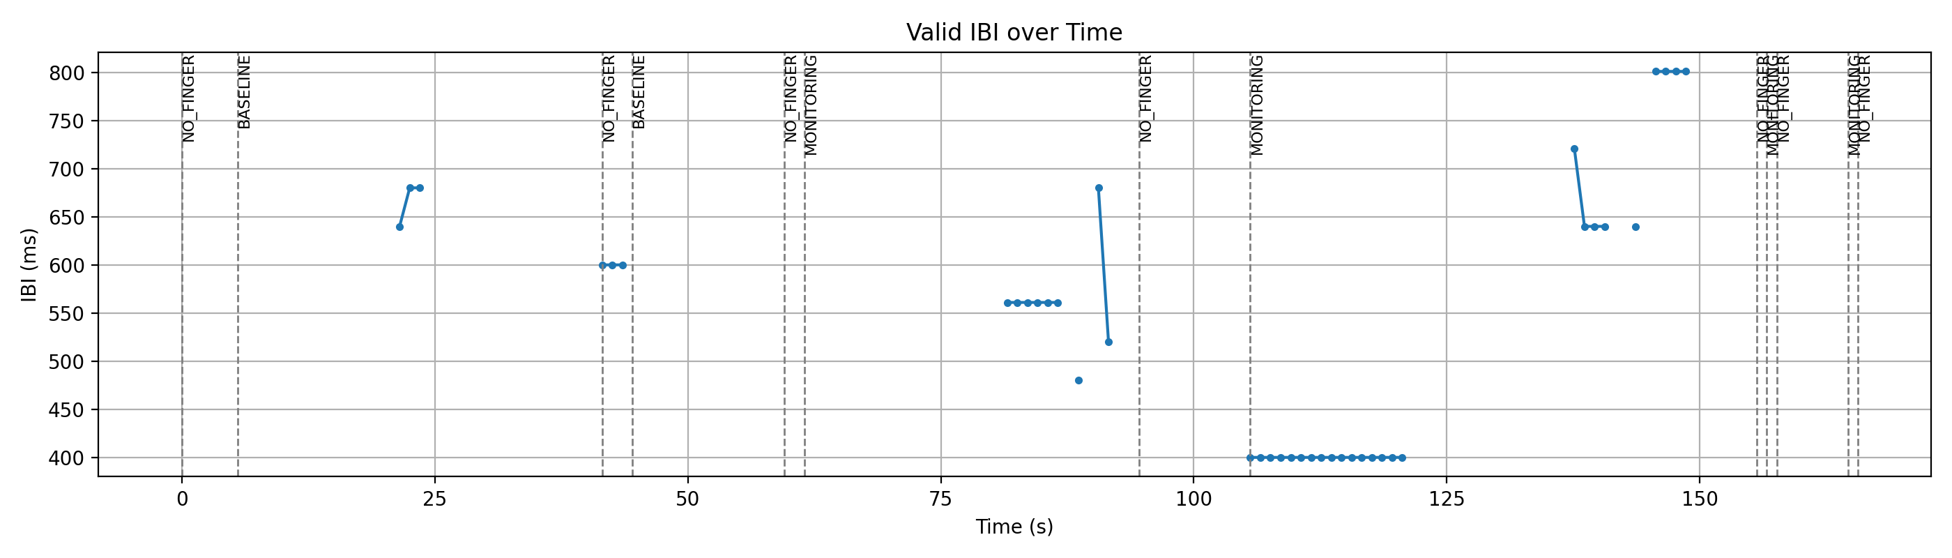
ppg_realtime_results/graphs_20260503_171810/06_valid_ibi.png
