hyyj04/Bio-Grip/ppg_realtime_results/graphs_20260503_180030/01_ir_raw.png

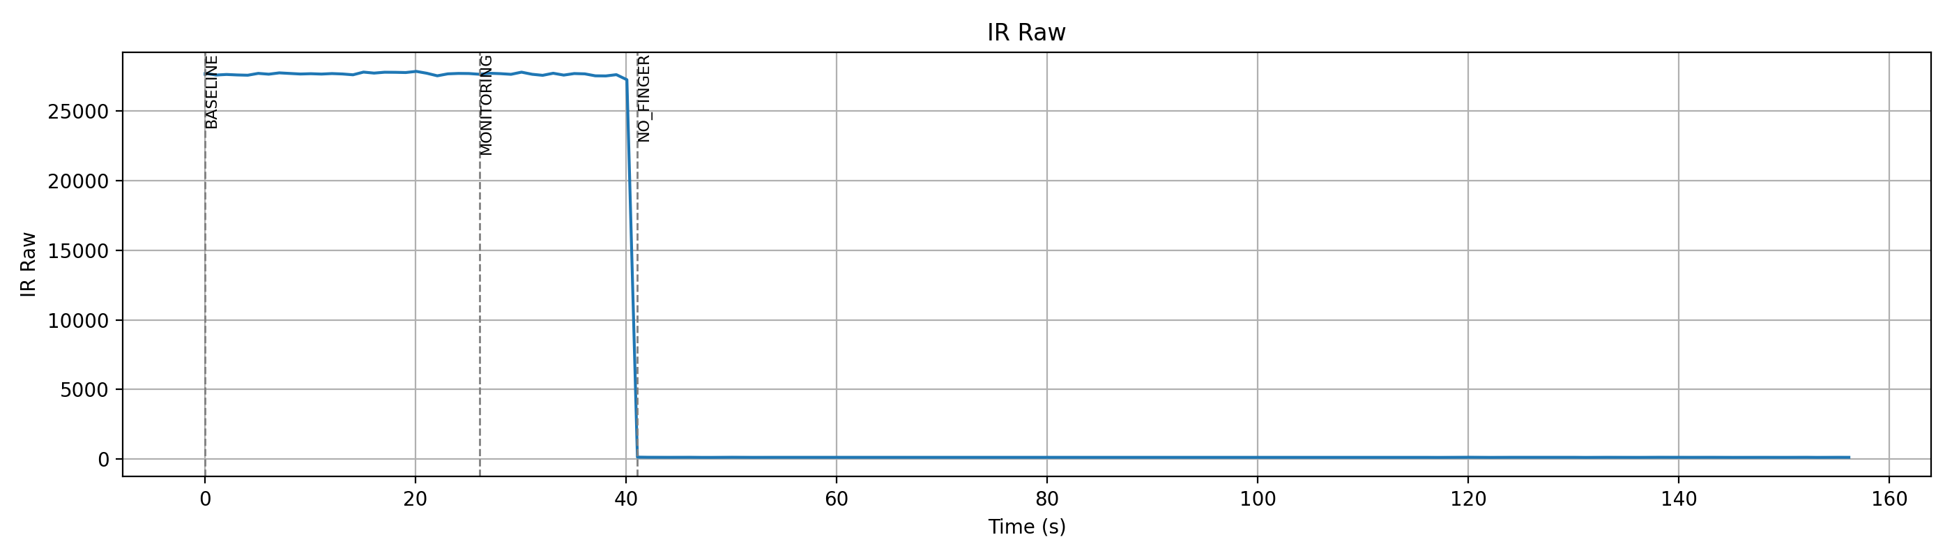
ppg_realtime_results/graphs_20260503_180030/01_ir_raw.png
