hyyj04/Bio-Grip/ppg_realtime_results/graphs_20260503_180030/03_mean_hr.png

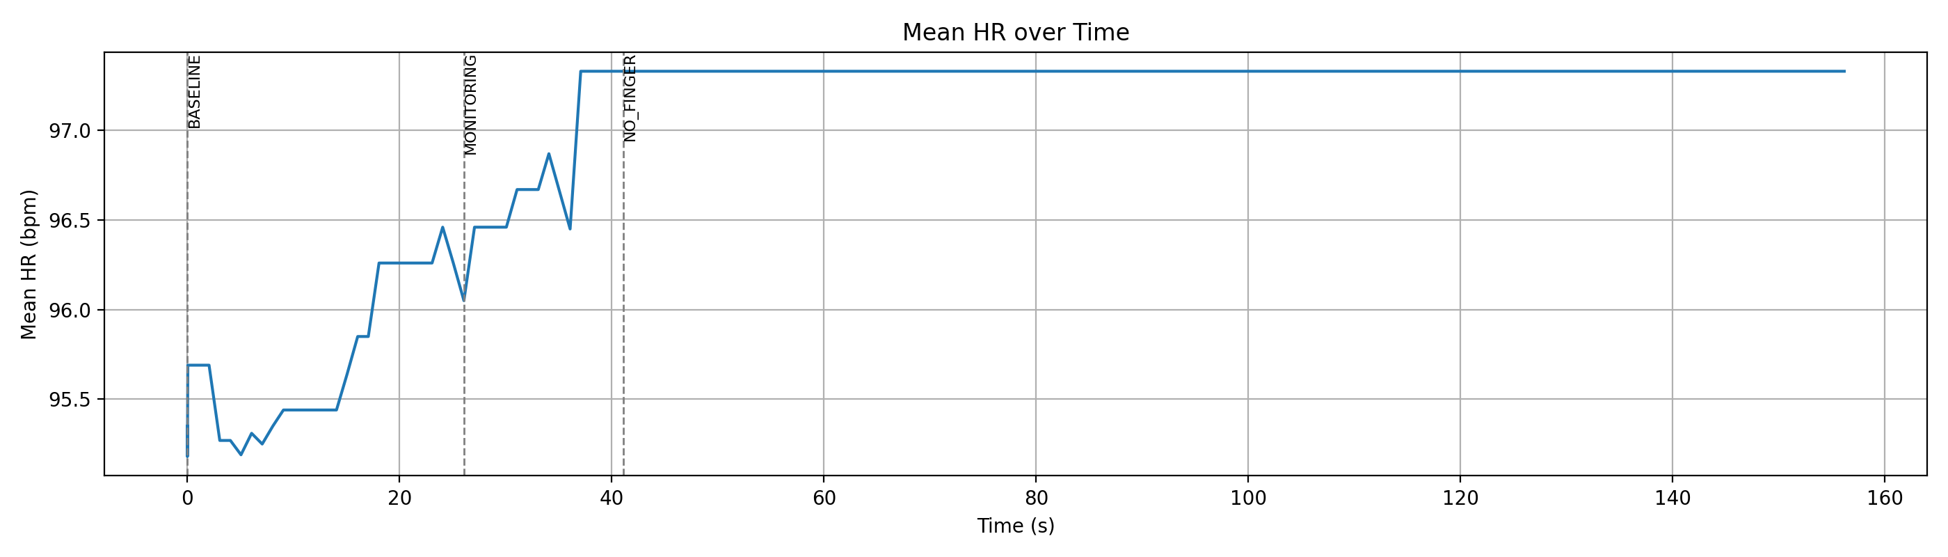
ppg_realtime_results/graphs_20260503_180030/03_mean_hr.png
