hyyj04/Bio-Grip/ppg_realtime_results/graphs_20260503_183948/01_ir_raw.png

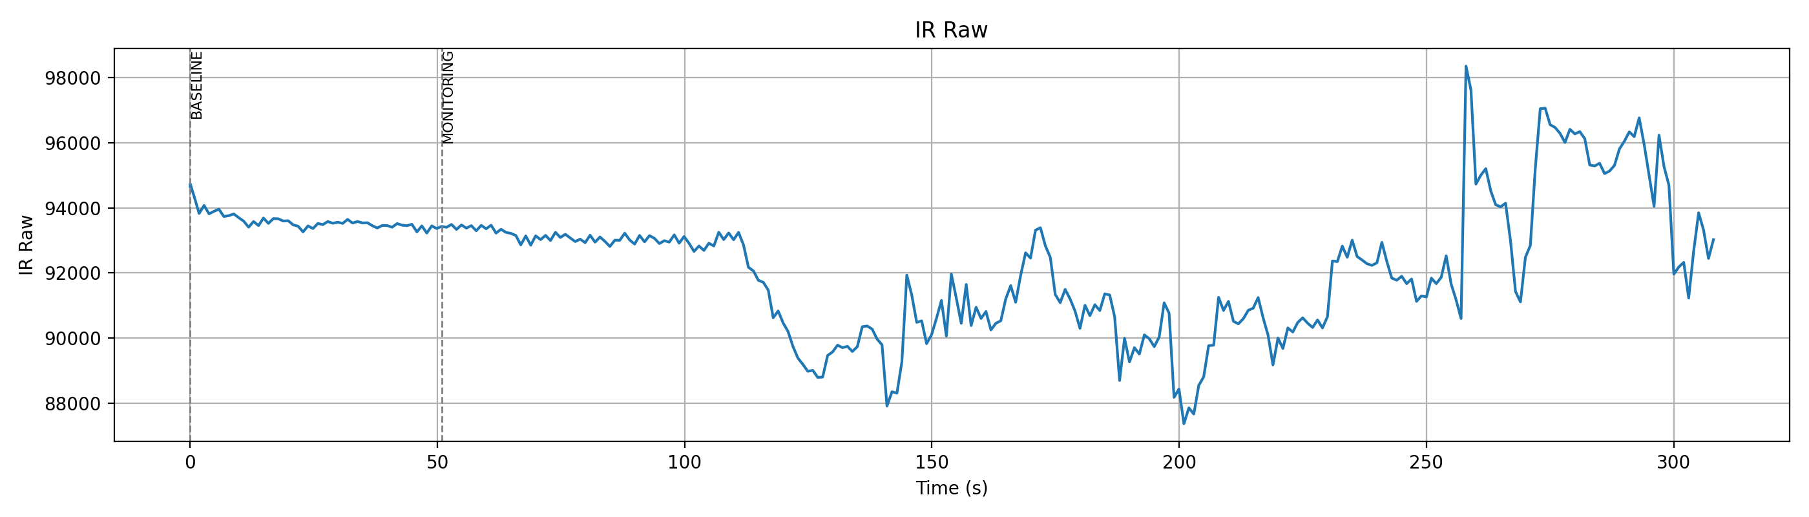
ppg_realtime_results/graphs_20260503_183948/01_ir_raw.png
