hyyj04/Bio-Grip/ppg_realtime_results/graphs_20260503_183948/03_mean_hr.png

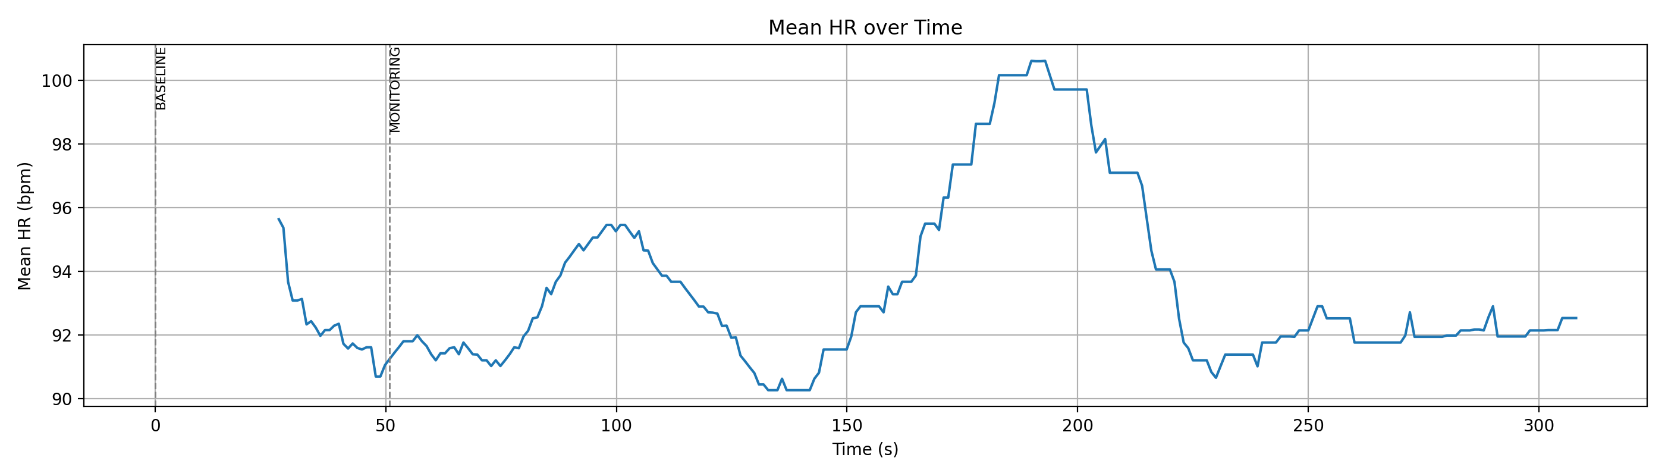
ppg_realtime_results/graphs_20260503_183948/03_mean_hr.png
