hyyj04/Bio-Grip/ppg_realtime_results/graphs_20260503_183948/04_sdnn.png

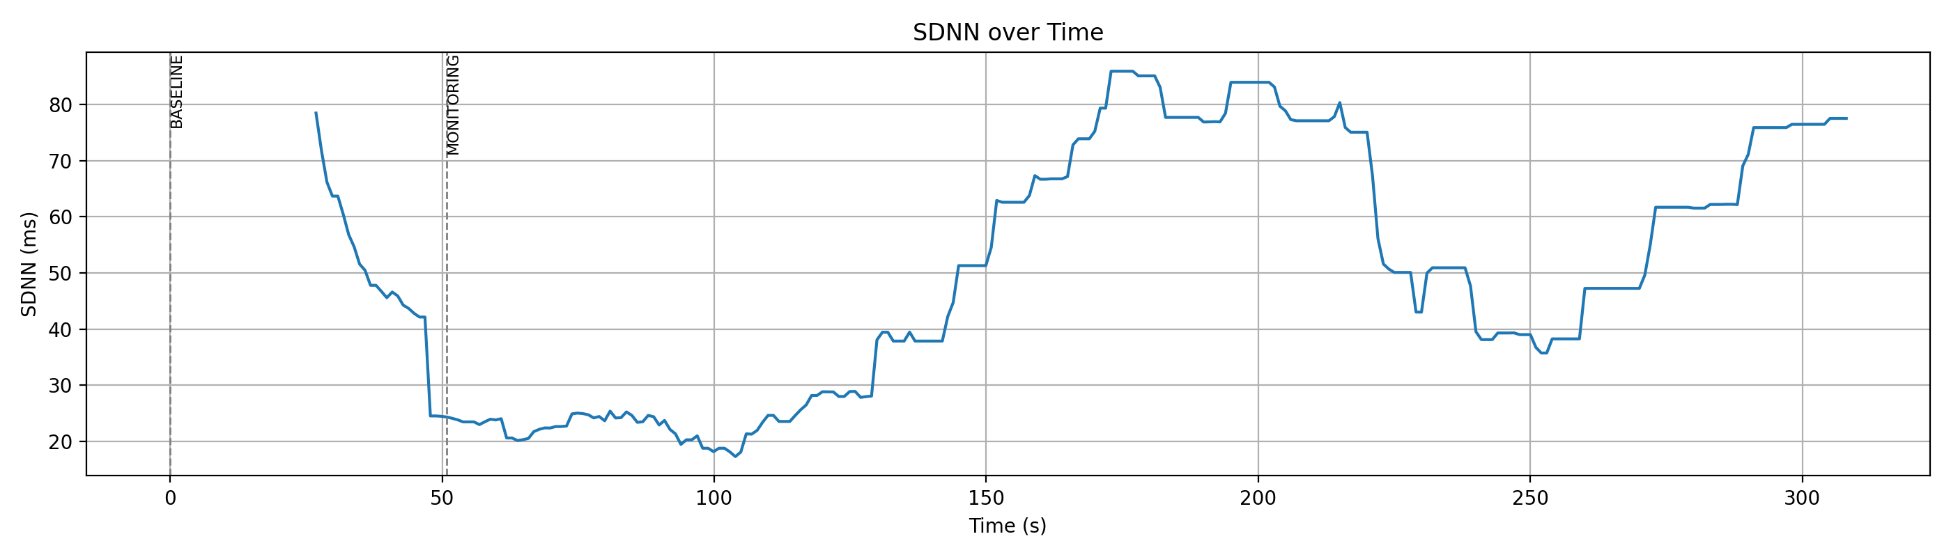
ppg_realtime_results/graphs_20260503_183948/04_sdnn.png
