hyyj04/Bio-Grip/(commit log)

2026-03-30 PPG Sensor Raw Data 획득
2026-03-30 PPG Raw Data Folder Update, PPG Raw Data .csv file Update
    [PPG_RawData1.csv]
2026-03-30 folder 정리
    [PPG_RawData1.csv]
2026-03-30 GSR RawData code, csv, matlab code update
    [GSR_RawData1.csv]
2026-03-31 PPG sensor datasheet update
2026-03-31 get_PPG_RawData src & RawData.csv file update
    [PPG_RawData2.csv, PPG_RawData3.csv, PPG_RawData4.csv, PPG_RawData5.csv]
2026-03-31 hy PPG Raw Data .csv update
    [PPG_RawData6hy.csv]
2026-03-31 GSR Raw Data .csv update
    [GSR_RawData2.csv, GSR_RawData3.csv, GSR_RawData4.csv, GSR_RawData5.csv]
2026-03-31 GSR Raw Data update & code update
    [GSR_RawData2.csv, GSR_RawData3.csv, GSR_RawData4.csv, GSR_RawData5.csv]
2026-04-04 folder change
    [GSR_RawData1.csv, GSR_RawData2.csv, PPG_RawData1.csv, PPG_RawData2.csv, PPG_RawData3.csv, PPG_RawData4.csv, PPG_RawData5.csv, PPG_RawData6hy.csv]
2026-04-10 PPG 신호 처리
2026-04-14 메인 함수
2026-04-14 주석 변경
2026-04-14 Revise README with detailed project information
    Updated project overview, objectives, features, system configuration, operation flow, measurement indicators, expected effects, and project structure in README.
2026-04-15 Update header format in 멘토링.md
2026-04-18 팀 사진 업데이트
2026-04-18 팀 사진 등록 수정
2026-04-20 4월 멘토링 결과
2026-05-03 PPG 실시간 처리 코드 & 측정 데이터 계산
2026-05-03 Add PPG Arduino realtime code
2026-05-03 Add GSR realtime Arduino code
2026-05-03 Add gsr z-score implement csv file
    [gsr_zscore_realtime_비안정.csv, gsr_zscore_realtime_안정.csv]
2026-05-03 수정
    Add automatic Arduino reset on connection and modify timing logic.
    [save_integrated_csv.py]
2026-05-03 주석 및 csv 결과, 그래프 저장
    [ppg_gsr_integrated_20260503_215318.csv, ppg_gsr_integrated_20260503_215329.csv, ppg_mcu_realtime_processing_20260503_171452.csv, ppg_mcu_realtime_processing_20260503_171514.csv, ppg_mcu_realtime_processing_20260503_171810.csv, ppg_mcu_realtime_processing_20260503_180030.csv, ppg_mcu_realtime_processing_20260503_183948.csv]
2026-05-04 코드 변경
    Updated GSR signal processing parameters and logic for improved accuracy and functionality.
2026-05-04 BLE Frame
2026-05-04 코드 변경
2026-05-04 Add BLE CSV Logger for BioGrip_Feature
    This script connects to an Arduino BLE peripheral, sends commands, subscribes to notifications, decodes data packets, and saves the results to a CSV file.
2026-05-04 measure data rate code update
    [biogripdata_20260504_222926.csv, biogripdata_20260504_224032.csv, stress_data_20260504_214217.csv, stress_data_20260504_215926.csv]
2026-05-05 ble까지 전부 구현
2026-05-05 수정
    Updated packet structure to include a sequence number and adjusted related logic for handling missing packets.
2026-05-05 BLE 측정 결과 및 platformio 파일로 재작성
    [ppg_gsr_ble_20260505_083415.csv, ppg_gsr_ble_20260505_091217.csv, ppg_gsr_ble_20260505_092447.csv, ppg_gsr_ble_20260505_094000.csv]
2026-05-06 260506 기준 완성 코드 platformio 프로젝트로 생성
2026-05-13 grid search file update 2
    [ppg_gsr_ble_20260506_215906.csv]
2026-05-14 ble test csv file update
    [ppg_gsr_ble_20260514_214205.csv, ppg_gsr_ble_20260514_220411.csv, ppg_gsr_ble_20260514_222045.csv, ppg_gsr_ble_20260514_223130.csv]
2026-05-17 코드 수정
2026-05-23 통합 코드
2026-05-26 1-8차 csv 저장 파일 업로드
    [ppg_gsr_integrated_serial_1차측정.csv, ppg_gsr_integrated_serial_2차측정.csv, ppg_gsr_integrated_serial_3차측정.csv, ppg_gsr_integrated_serial_4차측정.csv, ppg_gsr_integrated_serial_5차측정.csv, ppg_gsr_integrated_serial_6차측정.csv, ppg_gsr_integrated_serial_7차측정.csv, ppg_gsr_integrated_serial_8차측정.csv]
2026-05-26 수정 csv 파일 업로드
    [ppg_gsr_integrated_serial_v4scr수정후1차측정.csv, ppg_gsr_integrated_serial_v5수정후rest만측정.csv, ppg_gsr_integrated_serial_v5파라미터수정후rest만측정.csv]
2026-05-26 최종 stress score mean hr 제거된 통합 코드
2026-05-27 csv 파일 업로드
    [윤지_1차측정.csv, 윤지_2차측정.csv]
2026-06-03 요구사양서 수정
2026-06-03 요구사양서 재수정
2026-06-03 서식 변경
2026-06-03 서식 오류
2026-06-03 재재수정
2026-06-05 최종 앱 코드
2026-06-08 Update main.py
    코드 업데이트
2026-06-08 Update ble_manager.py
    ble_manager.py 업데이트
2026-06-12 최종 수정본 코드
    Refactor GSR and PPG initialization and processing logic. Update BLE notification intervals and add new state variables for better tracking.
    [ppg_gsr_integrated_v7.ino]
2026-07-02 5월 멘토링
    5월 멘토링
2026-07-25 7월 멘토링 사진
2026-08-02 7월 멘토링
